TormodDynna/Datamaskinprosjekt-gruppe-2-kicad/README.md

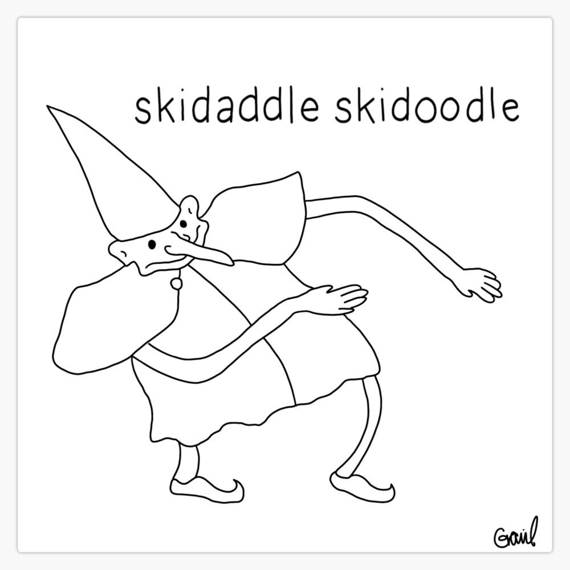
[picture p1: pictures/skidaddle-skidoodle.jpg]
Skidaddle Skidoodle
