TormodDynna/Datamaskinprosjekt-gruppe-2-kicad/pictures/barrel-jack-diagonal.png

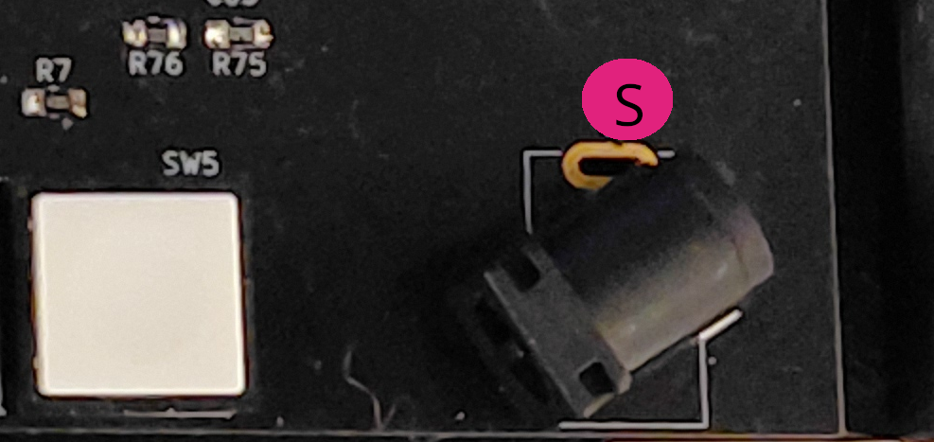
pictures/barrel-jack-diagonal.png
