TormodDynna/Datamaskinprosjekt-gruppe-2-kicad/pictures/PCB-backside.jpg

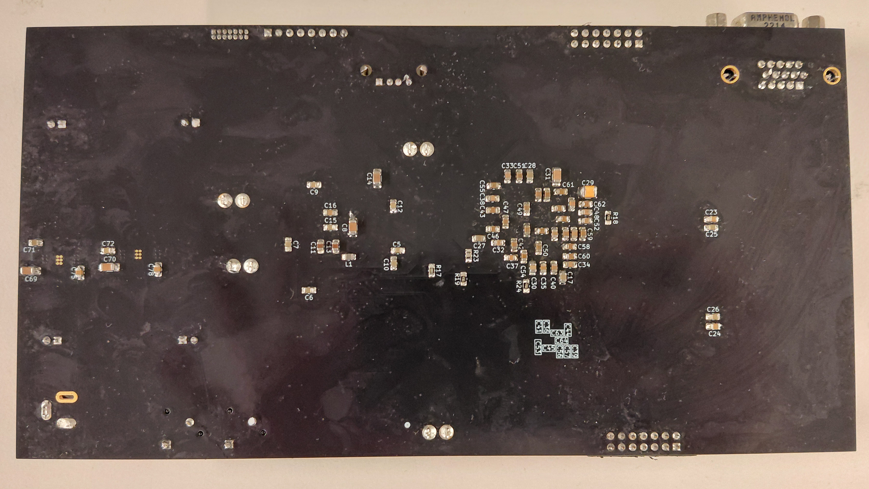
pictures/PCB-backside.jpg
