TormodDynna/Datamaskinprosjekt-gruppe-2-kicad/pictures/PCB-overview/final-PCB-TDT4295.jpg

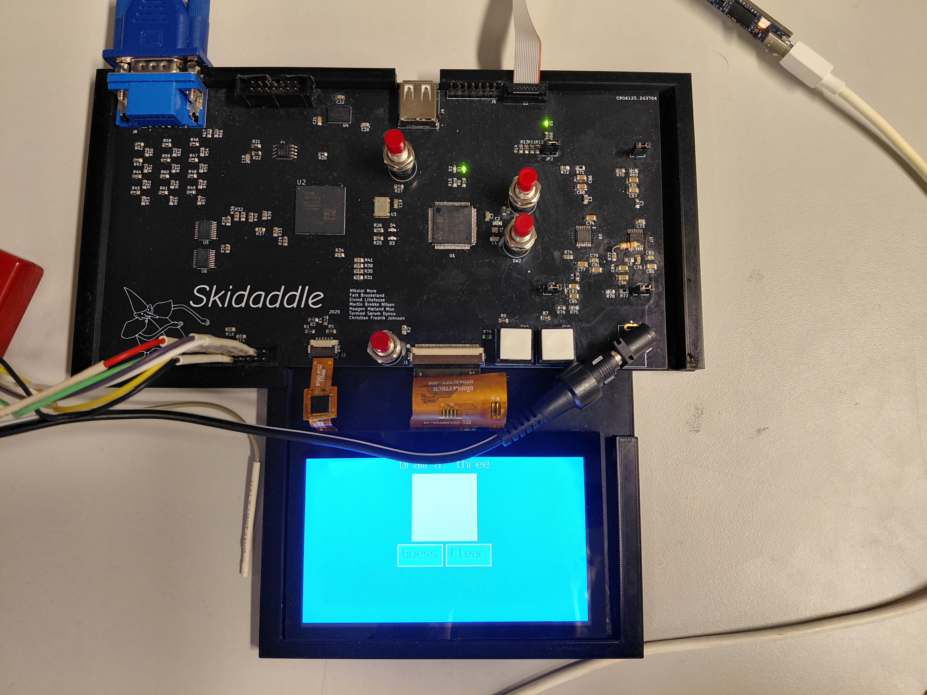
pictures/PCB-overview/final-PCB-TDT4295.jpg
