TormodDynna/Datamaskinprosjekt-gruppe-2-kicad/pictures/system-overview/oversikt-over-system.png

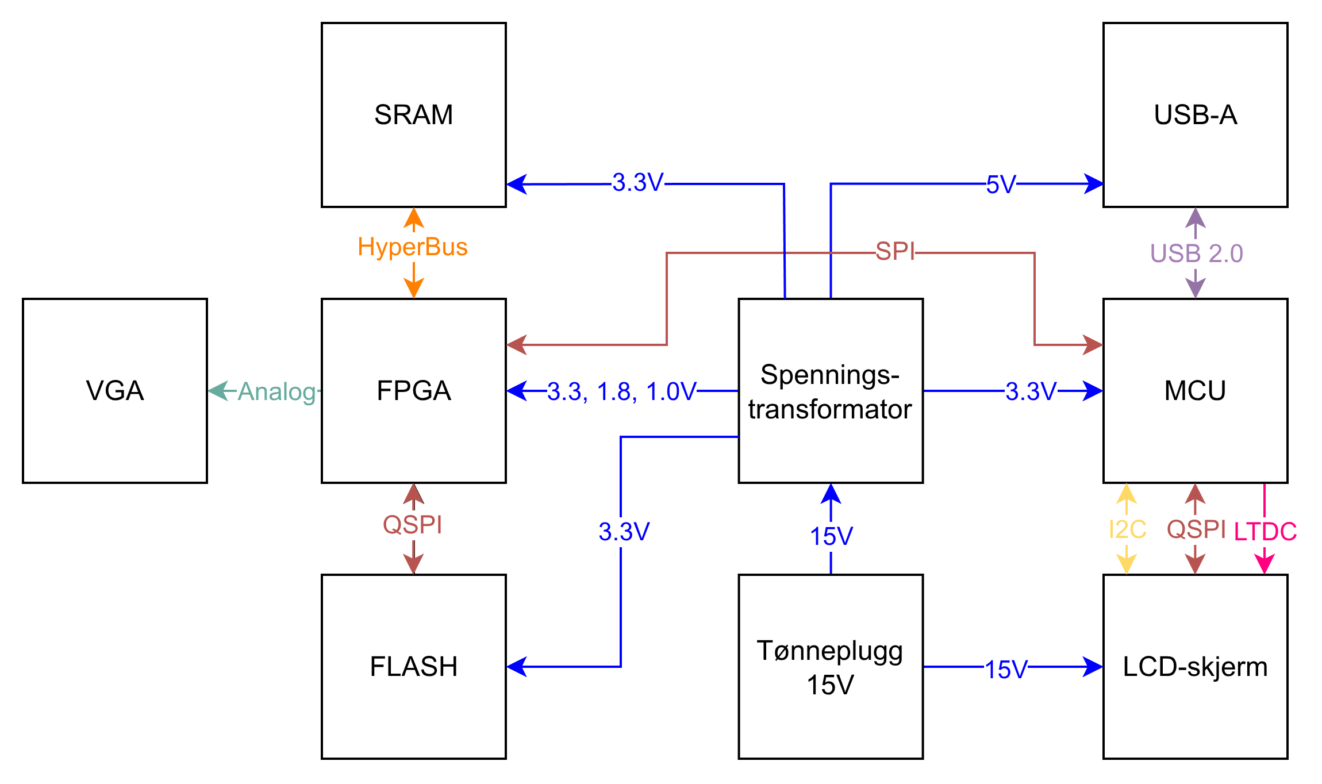
pictures/system-overview/oversikt-over-system.png
