TormodDynna/Datamaskinprosjekt-gruppe-2-kicad/pictures/voltage-transformer-correction/circle-correction-voltage-transformer.png

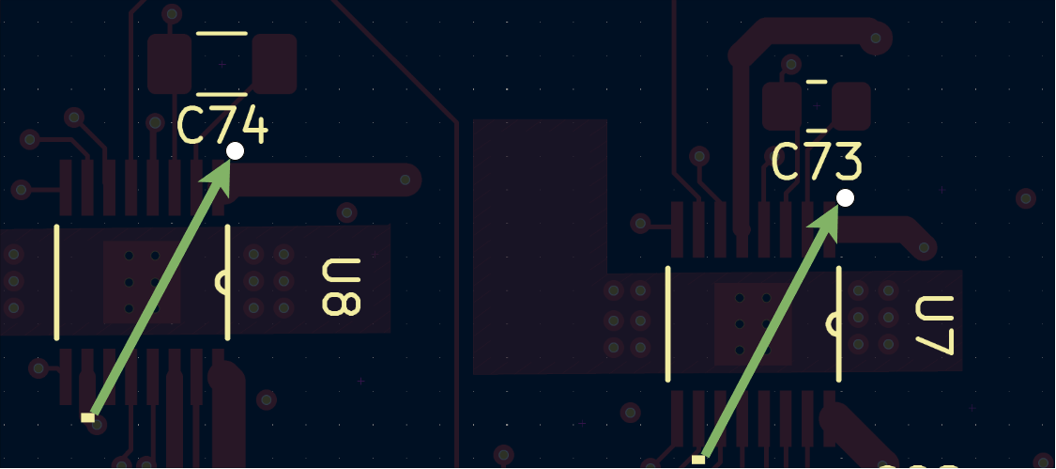
pictures/voltage-transformer-correction/circle-correction-voltage-transformer.png
