TormodDynna/Datamaskinprosjekt-gruppe-2-kicad/pictures/voltage-transformer-correction/transformer-circle.png

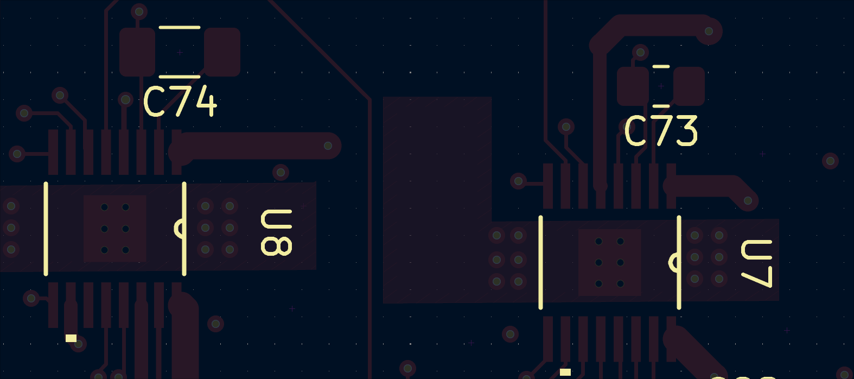
pictures/voltage-transformer-correction/transformer-circle.png
