TormodDynna/Datamaskinprosjekt-gruppe-2-kicad/Handleliste-hardware.xlsx

Komponent | Produsent | Modell | Link | Antall (per PCB) | Antall (x3) | Kjøpe | Pris enkelt | Pris tot | Sendt inn | Faktisk kjøpeantall
MCU | ST Electronics | STM32U5G7VJT6Q | https://www.digikey.no/no/products/detail/stmicroelectronics/STM32U5G7VJT6Q/21700656 | 1 | 3 | 3 | 173.7 | 521.1 | FALSE | 3
MCU/LCD 45-pin connector | Hirose | FH12-45S-0.5SH(55) | https://www.digikey.no/no/products/detail/hirose-electric-co-ltd/FH12-45S-0-5SH-55/1110329 | 1 | 3 | 3 | 29.03 | 87.09 | TRUE
MCU/LCD 6-pin connector | Hirose | FH12-6S-1SH(55) | https://www.digikey.no/no/products/detail/hirose-electric-co-ltd/FH12-6S-1SH-55/1110359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 | 1 | 3 | 3 | 10.09 | 30.27 | TRUE
LCD Breakout 45-pin | Adafruit | 1492 | https://www.digikey.no/no/products/detail/adafruit-industries-llc/1492/5154671 | 1 | 3 | 3 | 30.05 | 90.15 | TRUE
LCD Breakout 6-pin | Chip Quick | FPC100P010 | https://www.digikey.no/no/products/detail/chip-quik-inc/FPC100P010/5014766 | 1 | 3 | 3 | 37.59 | 112.77 | TRUE
LCD Display | Mouser | 758-DT043CTFTIPS-PTS | https://no.mouser.com/ProductDetail/Displaytech/DT043CTFT-IPS-PTS | 1 | 3 | 3 | 542.36 | 1627.08 | TRUE
15V Power Jack | Same Sky | PJ-002A | https://www.digikey.no/no/products/detail/same-sky-formerly-cui-devices/PJ-002A/96962 | 1 | 3 | 3 | 5.3 | 15.9 | FALSE | 3
15V Power Supply | Phihong | PSA15R-150P6-R | https://www.digikey.no/no/products/detail/phihong-usa/PSA15R-150P6-R/5247157 | 1 | 3 | 3 | 93.52 | 280.56 | FALSE | 4
MCU Debug Connector | ST Electronics | STLINK-V3MINIE | https://www.digikey.no/no/products/detail/stmicroelectronics/STLINK-V3MINIE/16284301 | - |  |  |  | 0 | FALSE
USB-A port | On Shore Technology Inc. | USB-A1HSW6 | https://www.digikey.no/no/products/detail/on-shore-technology-inc/USB-A1HSW6/2677750 | 1 | 3 | 4 | 5.09 | 20.36 | FALSE | 4
Undo/Reset Button | C&K | KS11R21CQD | https://www.digikey.no/en/products/detail/c-k/KS11R21CQD/332668 | 2 | 6 | 8 | 28.93 | 231.44 | FALSE | 8
Cheap Button | E-Switch | PS1024ABLK | https://www.digikey.no/en/products/detail/e-switch/PS1024ABLK/81742 | 4 | 12 | 14 | 17.42 | 243.88 | FALSE | 14
VGA Transceiver | Texas Instruments | SN74ALVC245PWR | https://www.digikey.no/en/products/detail/texas-instruments/SN74ALVC245PWR/381176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 | 2 | 6 | 8 | 7.64 | 61.12 | FALSE | 10
LED (Grønn) | Lite-On Inc. | LTST-C193KGKT-5A | https://www.digikey.no/no/products/detail/liteon/LTST-C193KGKT-5A/2356242 | 3 | 9 | 12 | 2.04 | 24.48 | FALSE | 12
LED (Rød) | Lite-On Inc. | LTST-C193KRKT-5A | https://www.digikey.no/no/products/detail/liteon/LTST-C193KRKT-5A/2356244 | 2 | 6 | 8 | 1.73 | 13.84 | FALSE | 8
Krystall (48 MHz, MCU) | Murata Electronics | XRCGB48M000F4M00R0 | https://www.digikey.no/no/products/detail/murata-electronics/XRCGB48M000F4M00R0/2368388 | 1 | 3 | 4 | 3.06 | 12.24 | FALSE | 4
Oscillator (100MHz, FPGA) | Connor Winfield | CWX813-100.0M | https://www.digikey.no/no/products/detail/connor-winfield/CWX813-100-0M/695541 | 1 | 3 | 3 | 51.96 | 155.88 | FALSE | 3
Flash (FPGA) | GigaDevice Semiconductor | GD25F128FS2GR | https://www.digikey.no/no/products/detail/gigadevice-semiconductor-hk-limited/GD25F128FS2GR/20531633 | 1 | 3 | 4 | 38.1 | 152.4 | FALSE | 4
Nedtransformator (Power Supply) | Texas Instruments | TPS54294PWP | https://www.digikey.no/no/products/detail/texas-instruments/TPS54294PWP/2812688 | 2 | 6 | 7 | 33.21 | 232.47 | FALSE | 7
SRAM (FPGA) | Integrated Silicon Solution Inc. | IS66WVH16M8DBLL-100B1LI | https://www.digikey.no/no/products/detail/issi-integrated-silicon-solution-inc/IS66WVH16M8DBLL-100B1LI/6202025 | 1 | 3 | 5 | 48.9 | 244.5 | FALSE | 5
FPGA Debug Header (2x7, 2.54mm) | Sullins Connector Solutions | SBH11-PBPC-D07-ST-BK | https://www.digikey.no/en/products/detail/sullins-connector-solutions/SBH11-PBPC-D07-ST-BK/1990063 | 1 | 3 | 3 | 3.26 | 9.78 | FALSE | 4
FPGA pin header (2x7, 2.54mm) | Sullins Connector Solutions | SBH11-PBPC-D07-ST-BK | https://www.digikey.no/en/products/detail/sullins-connector-solutions/SBH11-PBPC-D07-ST-BK/1990063 | 1 | 3 | 3 | 3.26 | 9.78 | FALSE | 3
MCU Debug Header (2x7, 1.27mm) | CNC Tech | 1175-1630-ND | https://www.digikey.no/en/products/detail/cnc-tech/3220-14-0100-00/3883664 | 1 | 3 | 3 | 7.74 | 23.22 | FALSE | 4
MCU pin header (1x8, 2.54mm) | Würth Elektronik | 61300811121 | https://www.digikey.no/en/products/detail/w%C3%BCrth-elektronik/61300811121/4846839 | 1 | 3 | 3 | 3.67 | 11.01 | FALSE | 4
FPGA | AMD | XC7A100T-2FTG256I | https://www.digikey.no/no/products/detail/amd/XC7A100T-2FTG256I/3925791 | 1 | 3 | 3 | 1774.7 | 5324.1 | FALSE | 3
VGA-port | Amphenol ICC | L77HDE15SD1CH4RHNVGA | https://www.digikey.no/en/products/detail/amphenol-cs-commercial-products/L77HDE15SD1CH4RHNVGA/25816614 | 1 | 3 | 3 | 19.05 | 57.15 | FALSE | 3
PWR Header Pin (2x1, 2.54mm) | Würth Elektronik | 61300211121 | https://www.digikey.no/no/products/detail/w%C3%BCrth-elektronik/61300211121/4846823 | 4 | 12 | 12 | 1.22 | 14.64 | FALSE | 14
Jumper cap | Sullins Connector Solutions | S9337-ND | https://www.digikey.no/en/products/detail/sullins-connector-solutions/QPC02SXGN-RC/2618262 | 4 | 12 | 12 | 1.02 | 12.24 | FALSE | 12
 |  |  |  |  | 0 |  |  | 0
Motstander |  |  |  |  | 0 |  |  | 0
12ohm | 805 |  | https://www.digikey.no/en/products/detail/yageo/RC0805JR-0712RL/728249 | 1 | 3 | 10 | 0.08 | 0.8 | FALSE | 10
47ohm | 805 |  | https://www.digikey.no/no/products/detail/stackpole-electronics-inc/RMCF0805JT47R0/1757848 | 4 | 12 | 16 | 1.02 | 16.32 | FALSE | 16
100ohm | 805 |  | https://www.digikey.no/no/products/detail/panasonic-electronic-components/ERA-6AEB101V/1465724 | 2 | 6 | 8 | 1.02 | 8.16 | FALSE | 10
270ohm | 805 |  | https://www.digikey.no/no/products/detail/vishay-dale/CRCW0805270RFKEAC/7922379 | 14 | 42 | 50 | 1.02 | 51 | FALSE | 50
330ohm | 805 |  | https://www.digikey.no/no/products/detail/stackpole-electronics-inc/RMCF0805FT330R/1760484 | 1 | 3 | 5 | 1.02 | 5.1 | FALSE | 10
536ohm | 805 |  | https://www.digikey.no/no/products/detail/yageo/RC0805FR-07536RL/728026 | 15 | 45 | 55 | 1.02 | 56.1 | FALSE | 55
2.4k | 805 |  | https://www.digikey.no/no/products/detail/yageo/RC0805FR-072K4L/727690 | 1 | 3 | 5 | 1.02 | 5.1 | FALSE | 10
4.7k | 805 |  | https://www.digikey.no/no/products/detail/vishay-dale/CRCW08054K70FKEAC/7928553 | 13 | 39 | 44 | 1.02 | 44.88 | FALSE | 50
6.81k | 805 |  | https://www.digikey.no/no/products/detail/yageo/RC0805FR-076K81L/728068 | 1 | 3 | 5 | 1.02 | 5.1 | FALSE | 10
10k | 805 |  | https://www.digikey.no/no/products/detail/susumu/RR1220P-103-D/432315 | 4 | 12 | 15 | 1.02 | 15.3 | FALSE | 15
22.1k | 805 |  | https://www.digikey.no/no/products/detail/stackpole-electronics-inc/RMCF0805FT22K1/1760211 | 4 | 12 | 15 | 1.02 | 15.3 | FALSE | 15
30.1k | 805 |  | https://www.digikey.no/no/products/detail/vishay-dale/CRCW080530K1FKEA/1175804 | 1 | 3 | 5 | 1.02 | 5.1 | FALSE | 10
73.2k | 805 |  | https://www.digikey.no/no/products/detail/panasonic-electronic-components/ERA-6AEB7322V/2025832 | 1 | 3 | 5 | 1.02 | 5.1 | FALSE | 5
100k | 805 |  | https://www.digikey.no/no/products/detail/susumu/RG2012P-104-B-T5/1240656 | 16 | 48 | 55 | 1.02 | 56.1 | FALSE | 55
124k | 805 |  | https://www.digikey.no/no/products/detail/yageo/RC0805FR-07124KL/727580 | 1 | 3 | 5 | 1.02 | 5.1 | FALSE | 10
Kondensator
6p | 805 |  | https://www.digikey.no/no/products/detail/kyocera-avx/08055A6R0CAT2A/1602729 | 2 | 6 | 8 | 2.04 | 16.32 | FALSE | 10
100n | 805 |  | https://www.digikey.no/no/products/detail/kemet/C0805C104K5RACTU/411169 | 21 | 63 | 70 | 0.82 | 57.4 | FALSE | 70
470n | 805 |  | https://www.digikey.no/no/products/detail/murata-electronics/GCJ21BR71H474KA12L/2783815 | 21 | 63 | 70 | 2.65 | 185.5 | FALSE | 70
1u | 805 |  | https://www.digikey.no/no/products/detail/samsung-electro-mechanics/CL21B105KAFNNNE/3886724 | 6 | 18 | 22 | 0.82 | 18.04 | FALSE | 22
2.2u | 805 |  | https://www.digikey.no/no/products/detail/tdk-corporation/C2012X7R1C225K125AB/569046 | 2 | 6 | 8 | 1.83 | 14.64 | FALSE | 10
4.7u | 805 |  | https://www.digikey.no/no/products/detail/samsung-electro-mechanics/CL21A475KAQNNNE/3886902 | 12 | 36 | 42 | 1.02 | 42.84 | FALSE | 50
47u | 805 |  | https://www.digikey.no/no/products/detail/samsung-electro-mechanics/CL21A476MQYNNNE/3887510 | 4 | 12 | 15 | 1.32 | 19.8 | FALSE | 15
10u | 1206 |  | https://www.digikey.no/no/products/detail/samsung-electro-mechanics/CL31B106KAHNNNE/3887462 | 8 | 24 | 28 | 0.82 | 22.96 | FALSE | 28
22u | 1206 |  | https://www.digikey.no/no/products/detail/samsung-electro-mechanics/CL31A226KAHNNNE/3888705 | 8 | 24 | 28 | 0.92 | 25.76 | FALSE | 28
100u | 1206 |  | https://www.digikey.no/no/products/detail/samsung-electro-mechanics/CL31A107MQHNNWE/10479833 | 1 | 3 | 5 | 4.08 | 20.4 | FALSE | 5
330u | 1210 |  | https://www.digikey.no/no/products/detail/murata-electronics/GRM32ER60G337ME05L/6155746 | 1 | 3 | 4 | 16.61 | 66.44 | FALSE | 4
Spoler
1,5u | 805 |  | https://www.digikey.no/no/products/detail/murata-electronics/LQM21PN1R5MC0D/1788280 | 2 | 6 | 8 | 1.73 | 13.84 | FALSE | 10
2,2u | 805 |  | https://www.digikey.no/no/products/detail/murata-electronics/DFE201210U-2R2M-P2/7595453 | 2 | 6 | 8 | 2.45 | 19.6 | FALSE | 8
3,3u | 805 |  | https://www.digikey.no/no/products/detail/murata-electronics/LQM21PN3R3MGRD/4359175 | 1 | 3 | 5 | 1.73 | 8.65 | FALSE | 5
 |  |  | Antall komponenter per PCB: | 212 |  |  | tot sum | 10446.2 | kr | 802
