TormodDynna/Datamaskinprosjekt-gruppe-2-kicad/tegnebrett/3D_models/PJ-002A.step

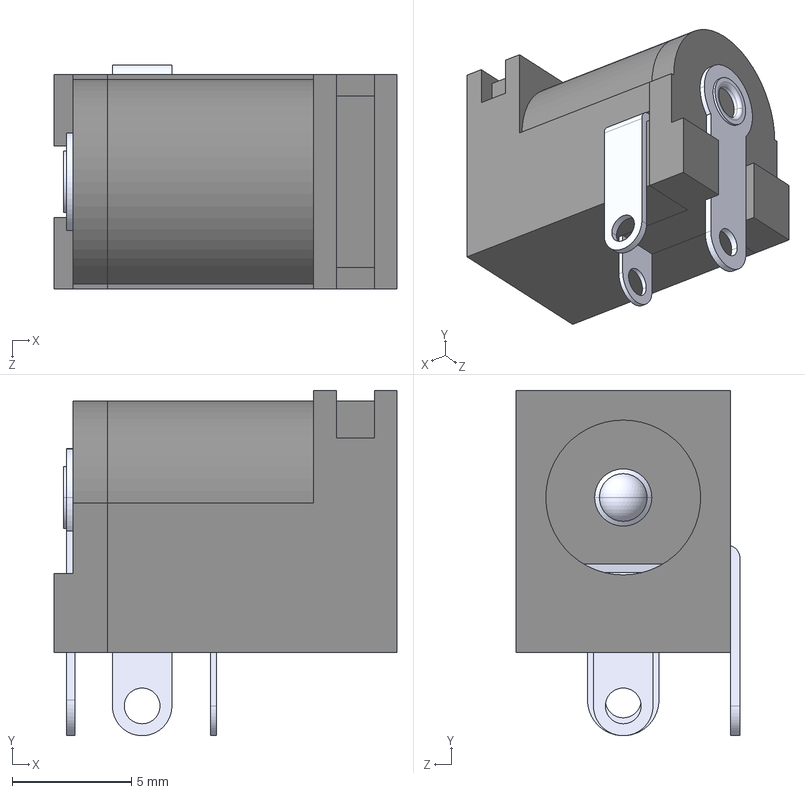
[picture p9: CAD file, 2025-09-28]
tegnebrett/3D_models/PJ-002A.step
14.4 x 14.5 x 9.40 mm
