TormodDynna/Datamaskinprosjekt-gruppe-2-kicad/tegnebrett/3D_models/USB-A1HSW6.step

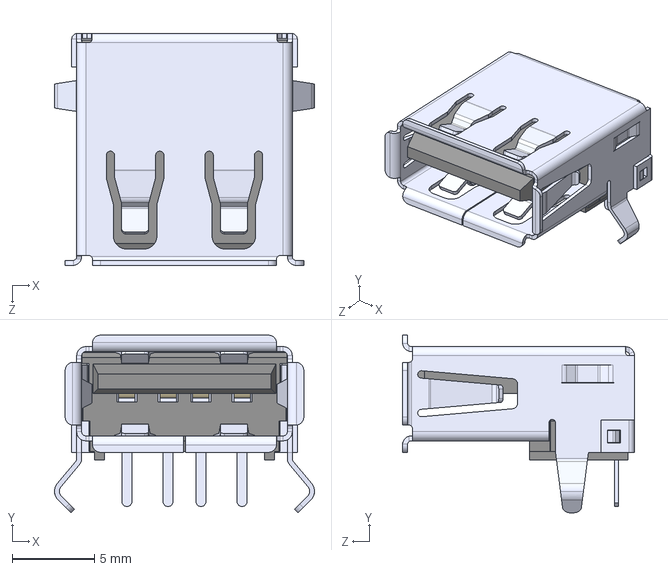
[picture p10: CAD file, 2025-09-25]
tegnebrett/3D_models/USB-A1HSW6.step
15.8 x 10.8 x 14.1 mm
