TormodDynna/Datamaskinprosjekt-gruppe-2-kicad/tegnebrett/3D_models/FH12-6S-1SH.igs

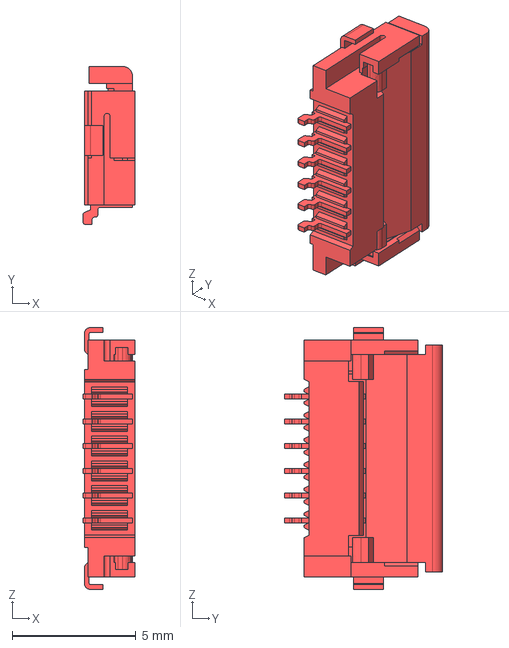
[picture p11: CAD file, 2025-09-25]
tegnebrett/3D_models/FH12-6S-1SH.igs
2.10 x 6.40 x 10.6 mm
