TormodDynna/Datamaskinprosjekt-gruppe-2-kicad/tegnebrett/tegnebrett.kicad_pcb

## KiCad design tegnebrett/tegnebrett.kicad_pcb (2025-10-04)

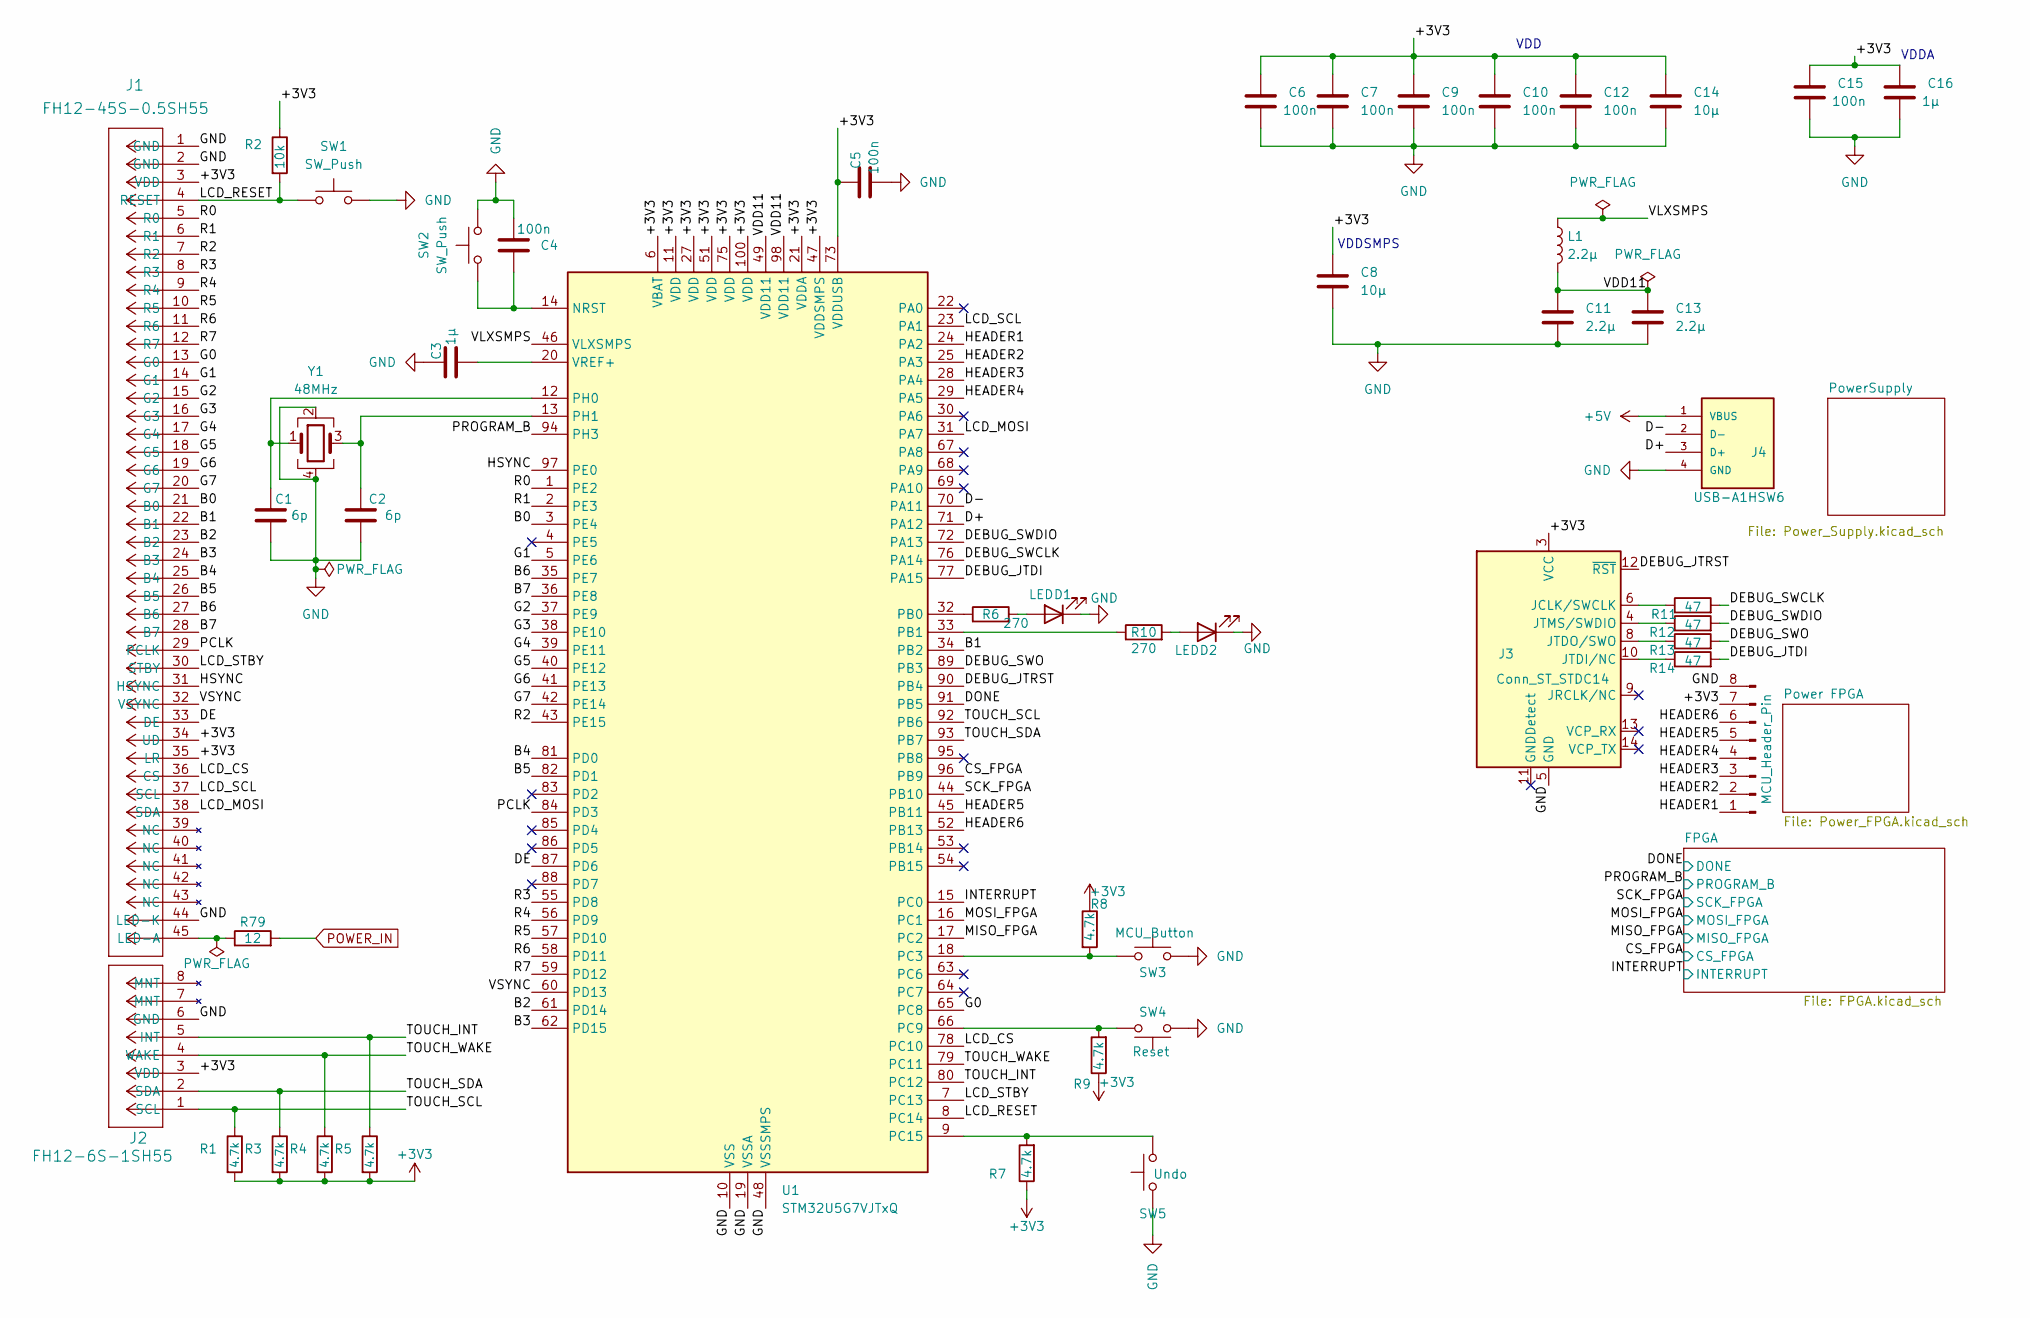
[picture p12: schematic tegnebrett.kicad_sch]

Parts:
C1, C2: 6p; C_0805_2012Metric_Pad1.18x1.45mm_HandSolder
C3, C16: 1µ; C_0805_2012Metric_Pad1.18x1.45mm_HandSolder
C4, C5, C6, C7, C9, C10, C12, C15: 100n; C_0805_2012Metric_Pad1.18x1.45mm_HandSolder
C8, C14: 10µ; C_1206_3216Metric_Pad1.33x1.80mm_HandSolder
C11, C13: 2.2µ; C_0805_2012Metric_Pad1.18x1.45mm_HandSolder
D1, D2: LED; LED_LTST-C193KGKT-5A_LTO-M
J1: FH12-45S-0.5SH55; CONN_45S-0.5SH55
J2: FH12-6S-1SH55; CON6_1X6_DRBF_HST_HIR
J3: Conn_ST_STDC14; PinHeader_2x07_P1.27mm_Vertical
J4: USB-A1HSW6; OST_USB-A1HSW6; PARTREV A
J5: MCU_Header_Pin; PinHeader_1x08_P2.54mm_Vertical
L1: 2.2µ; L_0805_2012Metric_Pad1.15x1.40mm_HandSolder
R1, R3, R4, R5, R7, R8, R9: 4.7k; R_0805_2012Metric_Pad1.20x1.40mm_HandSolder
R2: 10k; R_0805_2012Metric_Pad1.20x1.40mm_HandSolder
R6, R10: 270; R_0805_2012Metric_Pad1.20x1.40mm_HandSolder
R11, R12, R13, R14: 47; R_0805_2012Metric_Pad1.20x1.40mm_HandSolder
R79: 12; R_0805_2012Metric_Pad1.20x1.40mm_HandSolder
SW1, SW2: SW_Push; SW_PS1024ALRED
SW3: MCU_Button; SW_PS1024ALRED
SW4: Reset; SW_KS11R23CQD
SW5: Undo; SW_KS11R23CQD
U1: STM32U5G7VJTxQ; LQFP-100_14x14mm_P0.5mm
Y1: 48MHz; XRCGB48M000F4M00R0_MUR

Connections:
+3V3: C5.1, C6.1, C7.1, C8.1, C9.1, C10.1, C12.1, C14.1, C15.1, C16.1, J1.3 (VDD), J1.34 (UD), J1.35 (LR), J2.3 (VDD), J3.3 (VCC), J5.7, R1.2, R2.1, R3.2, R4.2, R5.2, R7.1, R8.1, R9.1, U1.6 (VBAT), U1.11 (VDD), U1.21 (VDDA), U1.27 (VDD), U1.47 (VDDSMPS), U1.51 (VDD), U1.73 (VDDUSB), U1.75 (VDD), U1.100 (VDD); also elsewhere on the board
+5V: J4.1 (VBUS); also elsewhere on the board
/B0: J1.21 (B0), U1.3 (PE4)
/B1: J1.22 (B1), U1.34 (PB2)
/B2: J1.23 (B2), U1.61 (PD14)
/B3: J1.24 (B3), U1.62 (PD15)
/B4: J1.25 (B4), U1.81 (PD0)
/B5: J1.26 (B5), U1.82 (PD1)
/B6: J1.27 (B6), U1.35 (PE7)
/B7: J1.28 (B7), U1.36 (PE8)
/CS_FPGA: U1.96 (PB9); also elsewhere on the board
/D+: J4.3 (D+), U1.71 (PA12)
/D-: J4.2 (D-), U1.70 (PA11)
/DE: J1.33 (DE), U1.87 (PD6)
/DEBUG_JTDI: R14.2, U1.77 (PA15)
/DEBUG_JTRST: J3.12 (~RST), U1.90 (PB4)
/DEBUG_SWCLK: R11.2, U1.76 (PA14)
/DEBUG_SWDIO: R12.2, U1.72 (PA13)
/DEBUG_SWO: R13.2, U1.89 (PB3)
/DONE: U1.91 (PB5); also elsewhere on the board
/G0: J1.13 (G0), U1.65 (PC8)
/G1: J1.14 (G1), U1.5 (PE6)
/G2: J1.15 (G2), U1.37 (PE9)
/G3: J1.16 (G3), U1.38 (PE10)
/G4: J1.17 (G4), U1.39 (PE11)
/G5: J1.18 (G5), U1.40 (PE12)
/G6: J1.19 (G6), U1.41 (PE13)
/G7: J1.20 (G7), U1.42 (PE14)
/HEADER1: J5.1, U1.24 (PA2)
/HEADER2: J5.2, U1.25 (PA3)
/HEADER3: J5.3, U1.28 (PA4)
/HEADER4: J5.4, U1.29 (PA5)
/HEADER5: J5.5, U1.45 (PB11)
/HEADER6: J5.6, U1.52 (PB13)
/HSYNC: J1.31 (HSYNC), U1.97 (PE0)
/INTERRUPT: U1.15 (PC0); also elsewhere on the board
/LCD_CS: J1.36 (CS), U1.78 (PC10)
/LCD_MOSI: J1.38 (SDA), U1.31 (PA7)
/LCD_RESET: J1.4 (RESET), R2.2, SW1.1, U1.8 (PC14)
/LCD_SCL: J1.37 (SCL), U1.23 (PA1)
/LCD_STBY: J1.30 (STBY), U1.7 (PC13)
/MISO_FPGA: U1.17 (PC2); also elsewhere on the board
/MOSI_FPGA: U1.16 (PC1); also elsewhere on the board
/PCLK: J1.29 (PCLK), U1.84 (PD3)
/PROGRAM_B: U1.94 (PH3); also elsewhere on the board
/R0: J1.5 (R0), U1.1 (PE2)
/R1: J1.6 (R1), U1.2 (PE3)
/R2: J1.7 (R2), U1.43 (PE15)
/R3: J1.8 (R3), U1.55 (PD8)
/R4: J1.9 (R4), U1.56 (PD9)
/R5: J1.10 (R5), U1.57 (PD10)
/R6: J1.11 (R6), U1.58 (PD11)
/R7: J1.12 (R7), U1.59 (PD12)
/SCK_FPGA: U1.44 (PB10); also elsewhere on the board
/TOUCH_INT: J2.5 (INT), R5.1, U1.80 (PC12)
/TOUCH_SCL: J2.1 (SCL), R1.1, U1.92 (PB6)
/TOUCH_SDA: J2.2 (SDA), R3.1, U1.93 (PB7)
/TOUCH_WAKE: J2.4 (WAKE), R4.1, U1.79 (PC11)
/VDD11: C11.1, C13.1, L1.2, U1.49 (VDD11), U1.98 (VDD11)
/VLXSMPS: L1.1, U1.46 (VLXSMPS)
/VSYNC: J1.32 (VSYNC), U1.60 (PD13)
GND: C1.2, C2.2, C3.1, C4.2, C5.2, C6.2, C7.2, C8.2, C9.2, C10.2, C11.2, C12.2, C13.2, C14.2, C15.2, C16.2, D1.1 (K), D2.1 (K), J1.1 (GND), J1.2 (GND), J1.44 (LED-K), J2.6 (GND), J3.5 (GND), J3.7 (GND), J4.4 (GND), J5.8, SW1.2, SW2.2, SW3.2, SW4.1, SW5.1, U1.10 (VSS), U1.19 (VSSA), U1.26 (VSS), U1.48 (VSSSMPS), U1.50 (VSS), U1.74 (VSS), U1.99 (VSS), Y1.2, Y1.4; also elsewhere on the board
unnamed: D1.2 (A), R6.2
unnamed: D2.2 (A), R10.2
unnamed: J1.45 (LED-A), R79.1
unnamed: J3.6 (JCLK/SWCLK), R11.1
unnamed: J3.10 (JTDI/NC), R14.1
unnamed: J3.8 (JTDO/SWO), R13.1
unnamed: J3.4 (JTMS/SWDIO), R12.1
unnamed: C4.1, SW2.1, U1.14 (NRST)
unnamed: R6.1, U1.32 (PB0)
unnamed: R10.1, U1.33 (PB1)
unnamed: R8.2, SW3.1, U1.18 (PC3)
unnamed: R9.2, SW4.3, U1.66 (PC9)
unnamed: R7.2, SW5.3, U1.9 (PC15)
unnamed: C1.1, U1.12 (PH0), Y1.1
unnamed: C2.1, U1.13 (PH1), Y1.3
unnamed: C3.2, U1.20 (VREF+)
POWER_IN: R79.2; also elsewhere on the board

Notes on the sheet:
VDD
VDDSMPS
VDDA

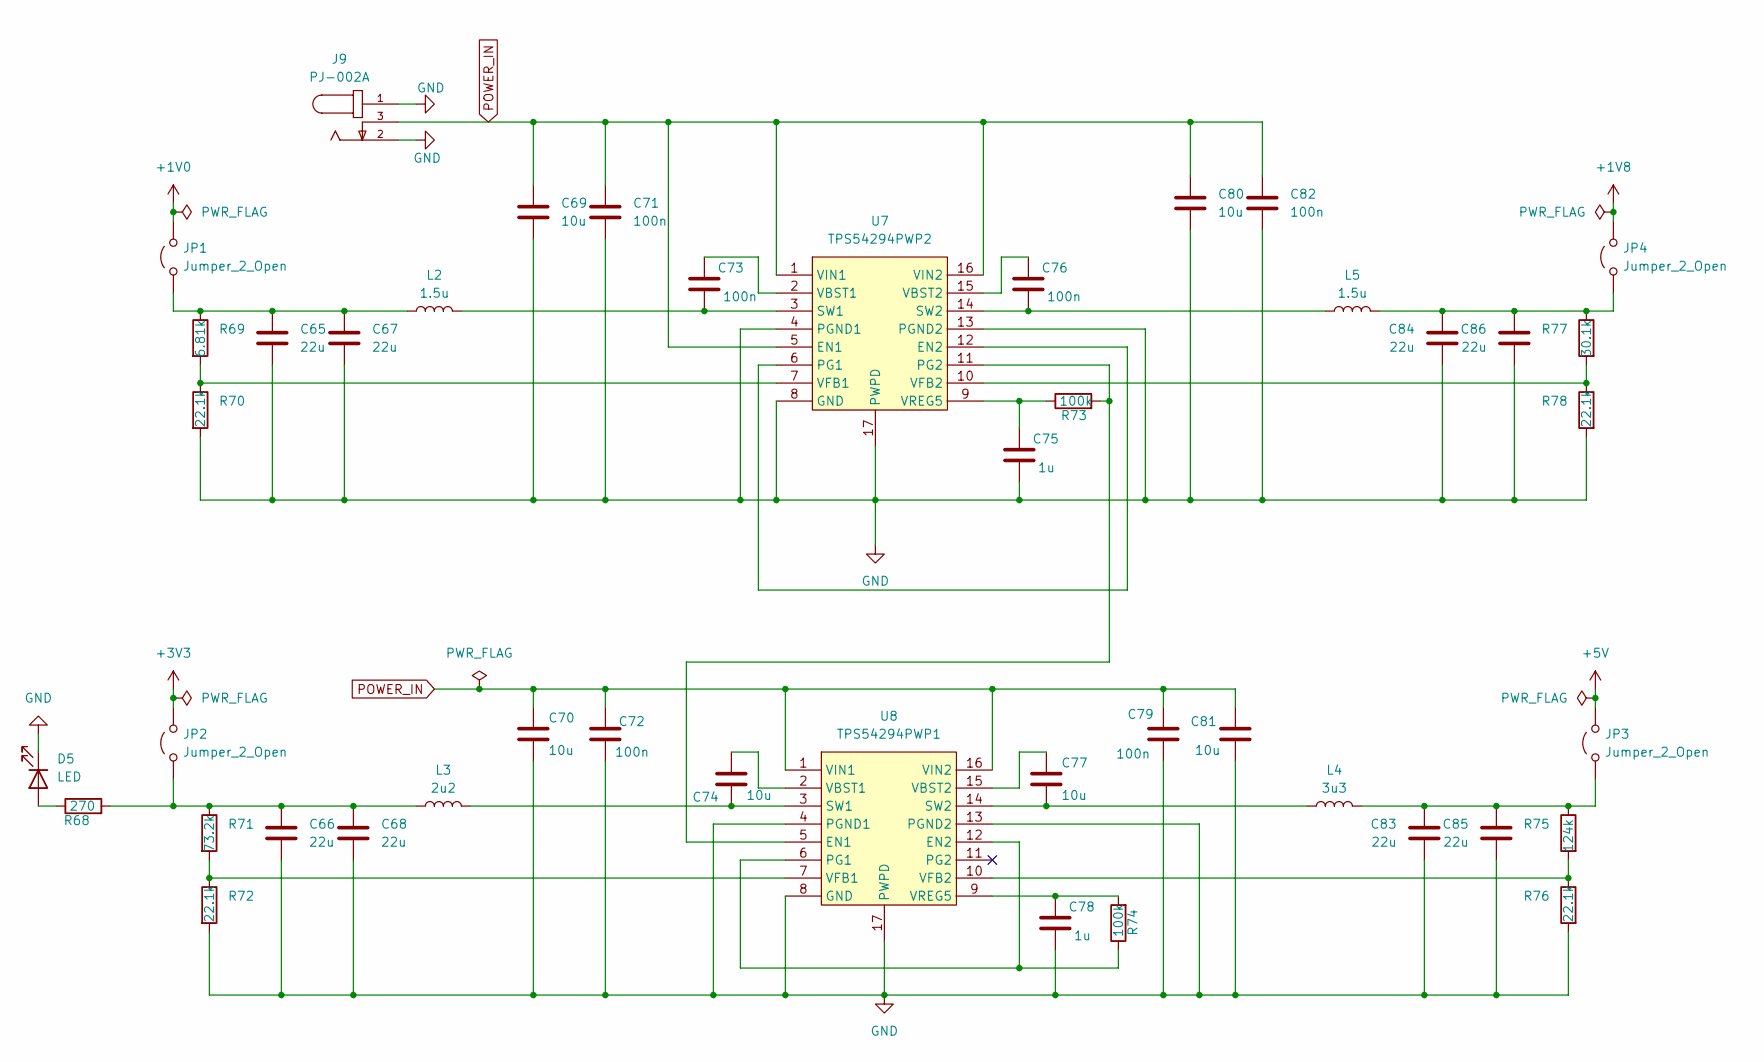
[picture p13: schematic Power_Supply.kicad_sch]

Parts:
C65, C66, C67, C68, C83, C84, C85, C86: 22u; C_1206_3216Metric_Pad1.33x1.80mm_HandSolder
C69, C70, C74, C77, C80, C81: 10u; C_1206_3216Metric_Pad1.33x1.80mm_HandSolder
C71, C72, C73, C76, C79, C82: 100n; C_0805_2012Metric_Pad1.18x1.45mm_HandSolder
C75, C78: 1u; C_0805_2012Metric_Pad1.18x1.45mm_HandSolder
D5: LED; LED_LTST-C193KGKT-5A_LTO-M
J9: PJ-002A; CUI_PJ-002A
JP1, JP2, JP3, JP4: Jumper_2_Open; PinHeader_1x02_P2.54mm_Vertical
L2, L5: 1.5u; L_0805_2012Metric_Pad1.15x1.40mm_HandSolder
L3: 2u2; L_0805_2012Metric_Pad1.15x1.40mm_HandSolder
L4: 3u3; L_0805_2012Metric_Pad1.15x1.40mm_HandSolder
R68: 270; R_0805_2012Metric_Pad1.20x1.40mm_HandSolder
R69: 6.81k; R_0805_2012Metric_Pad1.20x1.40mm_HandSolder
R70, R72, R76, R78: 22.1k; R_0805_2012Metric_Pad1.20x1.40mm_HandSolder
R71: 73.2k; R_0805_2012Metric_Pad1.20x1.40mm_HandSolder
R73, R74: 100k; R_0805_2012Metric_Pad1.20x1.40mm_HandSolder
R75: 124k; R_0805_2012Metric_Pad1.20x1.40mm_HandSolder
R77: 30.1k; R_0805_2012Metric_Pad1.20x1.40mm_HandSolder
U7: TPS54294PWP2; PWP16_2P31X2P46
U8: TPS54294PWP1; PWP16_2P31X2P46

Connections:
+1V0: JP1.2 (B); also elsewhere on the board
+1V8: JP4.2 (B); also elsewhere on the board
+3V3: JP2.2 (B); also elsewhere on the board
+5V: JP3.2 (B); also elsewhere on the board
GND: C65.2, C66.2, C67.2, C68.2, C69.2, C70.2, C71.2, C72.2, C75.2, C78.2, C79.2, C80.2, C81.2, C82.2, C83.2, C84.2, C85.2, C86.2, D5.1 (K), J9.1, J9.2, R70.2, R72.2, R76.2, R78.2, U7.4 (PGND1), U7.8 (GND), U7.13 (PGND2), U7.17 (PWPD), U8.4 (PGND1), U8.8 (GND), U8.13 (PGND2), U8.17 (PWPD); also elsewhere on the board
unnamed: D5.2 (A), R68.1
unnamed: C65.1, C67.1, JP1.1 (A), L2.1, R69.1
unnamed: C66.1, C68.1, JP2.1 (A), L3.1, R68.2, R71.1
unnamed: C83.1, C85.1, JP3.1 (A), L4.1, R75.1
unnamed: C84.1, C86.1, JP4.1 (A), L5.1, R77.1
unnamed: U7.6 (PG1), U7.12 (EN2)
unnamed: R73.2, U7.11 (PG2), U8.5 (EN1)
unnamed: C73.2, L2.2, U7.3 (SW1)
unnamed: C76.2, L5.2, U7.14 (SW2)
unnamed: C73.1, U7.2 (VBST1)
unnamed: C76.1, U7.15 (VBST2)
unnamed: R69.2, R70.1, U7.7 (VFB1)
unnamed: R77.2, R78.1, U7.10 (VFB2)
unnamed: C75.1, R73.1, U7.9 (VREG5)
unnamed: R74.1, U8.6 (PG1), U8.12 (EN2)
unnamed: C74.2, L3.2, U8.3 (SW1)
unnamed: C77.2, L4.2, U8.14 (SW2)
unnamed: C74.1, U8.2 (VBST1)
unnamed: C77.1, U8.15 (VBST2)
unnamed: R71.2, R72.1, U8.7 (VFB1)
unnamed: R75.2, R76.1, U8.10 (VFB2)
unnamed: C78.1, R74.2, U8.9 (VREG5)
POWER_IN: C69.1, C70.1, C71.1, C72.1, C79.1, C80.1, C81.1, C82.1, J9.3, U7.1 (VIN1), U7.5 (EN1), U7.16 (VIN2), U8.1 (VIN1), U8.16 (VIN2); also elsewhere on the board

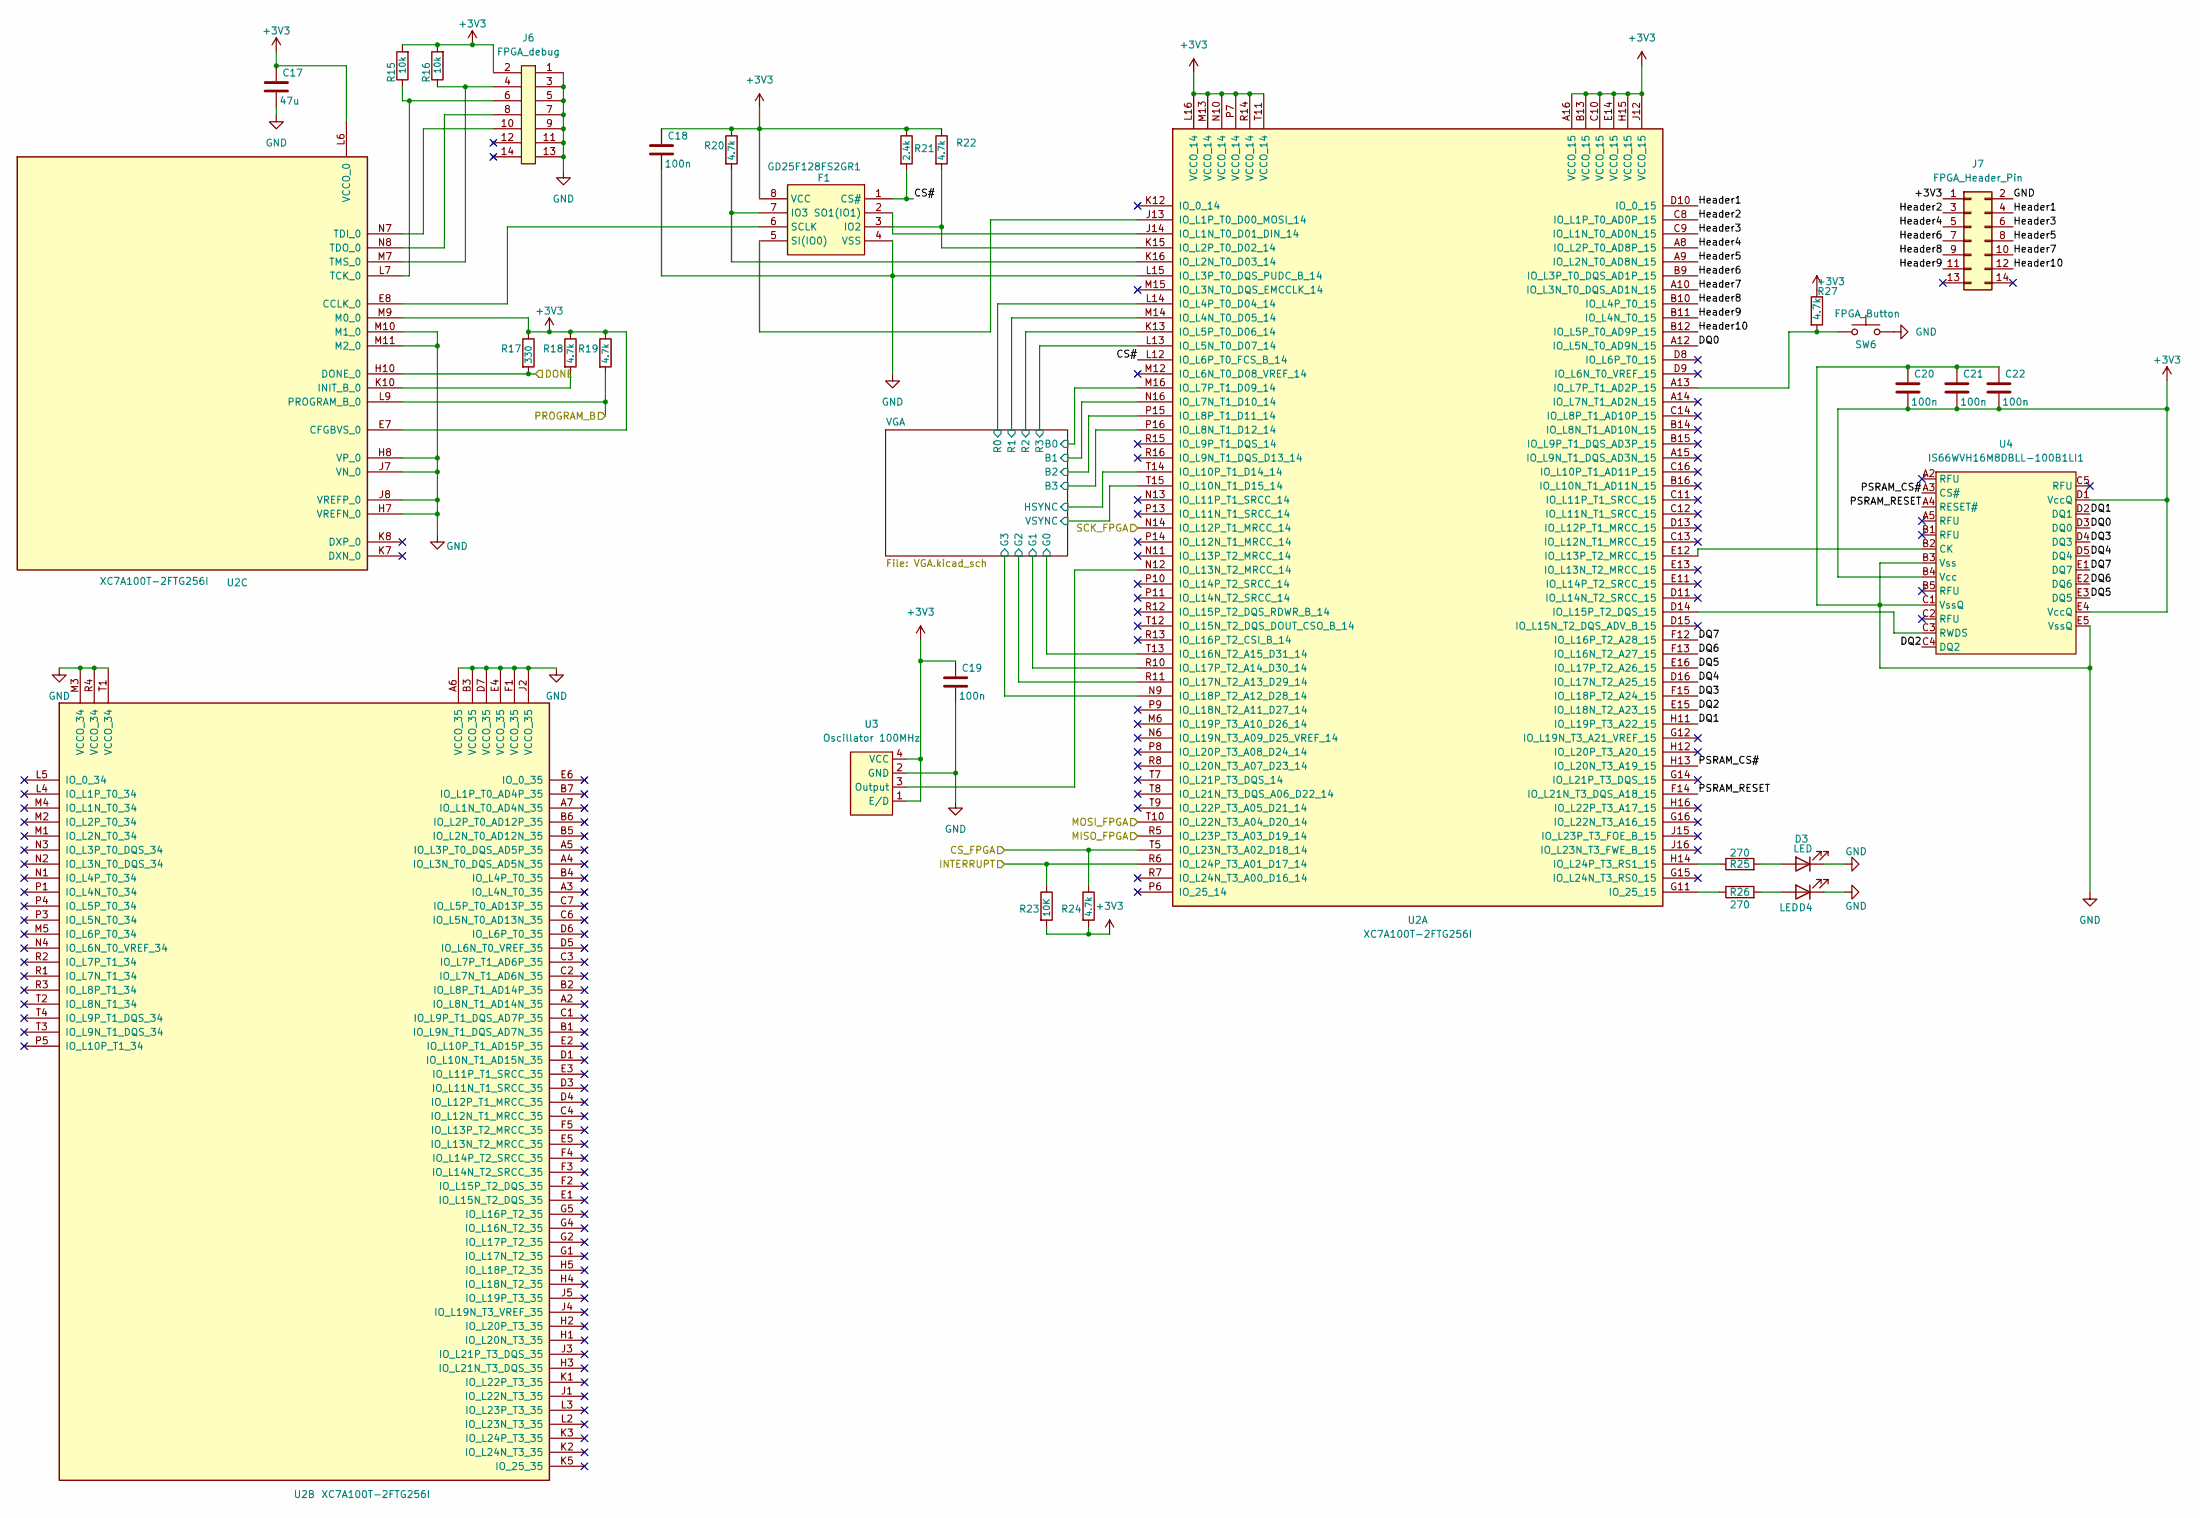
[picture p14: schematic FPGA.kicad_sch]

Parts:
C17: 47u; C_0805_2012Metric_Pad1.18x1.45mm_HandSolder
C18, C19, C20, C21, C22: 100n; C_0805_2012Metric_Pad1.18x1.45mm_HandSolder
D3, D4: LED; LED_LTST-C193KGKT-5A_LTO-M
F1: GD25F128FS2GR1; flash_tegnebrett
J6: FPGA_debug; PinHeader_2x07_P2.54mm_Vertical
J7: FPGA_Header_Pin; PinHeader_2x07_P2.54mm_Vertical
R15, R16: 10k; R_0805_2012Metric_Pad1.20x1.40mm_HandSolder
R17: 330; R_0805_2012Metric_Pad1.20x1.40mm_HandSolder
R18, R19, R20, R22, R24, R27: 4.7k; R_0805_2012Metric_Pad1.20x1.40mm_HandSolder
R21: 2.4k; R_0805_2012Metric_Pad1.20x1.40mm_HandSolder
R23: 10K; R_0805_2012Metric_Pad1.20x1.40mm_HandSolder
R25, R26: 270; R_0805_2012Metric_Pad1.20x1.40mm_HandSolder
SW6: FPGA_Button; SW_PS1024ALRED
U2: XC7A100T-2FTG256I; fpga
U3: Oscillator 100MHz; CWX813-100.0M_CNW
U4: IS66WVH16M8DBLL-100B1LI1; psram

Connections:
+3V3: C17.1, C18.1, C19.1, C20.2, C21.2, C22.2, F1.8 (VCC), J6.2, J7.1, R15.2, R16.2, R17.1, R18.1, R19.1, R20.1, R21.1, R22.1, R23.2, R24.2, R27.1, U2.A16 (VCCO_15), U2.B13 (VCCO_15), U2.C10 (VCCO_15), U2.E7 (CFGBVS_0), U2.E14 (VCCO_15), U2.H15 (VCCO_15), U2.J12 (VCCO_15), U2.L6 (VCCO_0), U2.L16 (VCCO_14), U2.M9 (M0_0), U2.M13 (VCCO_14), U2.N10 (VCCO_14), U2.P7 (VCCO_14), U2.R14 (VCCO_14), U2.T11 (VCCO_14), U3.1 (E/D), U3.4 (VCC), U4.B4 (Vcc), U4.D1 (VccQ), U4.E4 (VccQ); also elsewhere on the board
/CS_FPGA: R24.1, U2.T5 (IO_L23N_T3_A02_D18_14); also elsewhere on the board
/DONE: R17.2, U2.H10 (DONE_0); also elsewhere on the board
/FPGA/CS#: F1.1 (CS#), R21.2, U2.L12 (IO_L6P_T0_FCS_B_14)
/FPGA/DQ0: U2.A12 (IO_L5N_T0_AD9N_15), U4.D3 (DQ0)
/FPGA/DQ1: U2.H11 (IO_L19P_T3_A22_15), U4.D2 (DQ1)
/FPGA/DQ2: U2.E15 (IO_L18N_T2_A23_15), U4.C4 (DQ2)
/FPGA/DQ3: U2.F15 (IO_L18P_T2_A24_15), U4.D4 (DQ3)
/FPGA/DQ4: U2.D16 (IO_L17N_T2_A25_15), U4.D5 (DQ4)
/FPGA/DQ5: U2.E16 (IO_L17P_T2_A26_15), U4.E3 (DQ5)
/FPGA/DQ6: U2.F13 (IO_L16N_T2_A27_15), U4.E2 (DQ6)
/FPGA/DQ7: U2.F12 (IO_L16P_T2_A28_15), U4.E1 (DQ7)
/FPGA/Header1: J7.4, U2.D10 (IO_0_15)
/FPGA/Header2: J7.3, U2.C8 (IO_L1P_T0_AD0P_15)
/FPGA/Header3: J7.6, U2.C9 (IO_L1N_T0_AD0N_15)
/FPGA/Header4: J7.5, U2.A8 (IO_L2P_T0_AD8P_15)
/FPGA/Header5: J7.8, U2.A9 (IO_L2N_T0_AD8N_15)
/FPGA/Header6: J7.7, U2.B9 (IO_L3P_T0_DQS_AD1P_15)
/FPGA/Header7: J7.10, U2.A10 (IO_L3N_T0_DQS_AD1N_15)
/FPGA/Header8: J7.9, U2.B10 (IO_L4P_T0_15)
/FPGA/Header9: J7.11, U2.B11 (IO_L4N_T0_15)
/FPGA/Header10: J7.12, U2.B12 (IO_L5P_T0_AD9P_15)
/FPGA/PSRAM_CS#: U2.H13 (IO_L20N_T3_A19_15), U4.A3 (CS#)
/FPGA/PSRAM_RESET: U2.F14 (IO_L21N_T3_DQS_A18_15), U4.A4 (RESET#)
/FPGA/VGA/B0: U2.M16 (IO_L7P_T1_D09_14); also elsewhere on the board
/FPGA/VGA/B1: U2.N16 (IO_L7N_T1_D10_14); also elsewhere on the board
/FPGA/VGA/B2: U2.P15 (IO_L8P_T1_D11_14); also elsewhere on the board
/FPGA/VGA/B3: U2.P16 (IO_L8N_T1_D12_14); also elsewhere on the board
/FPGA/VGA/G0: U2.T13 (IO_L16N_T2_A15_D31_14); also elsewhere on the board
/FPGA/VGA/G1: U2.R10 (IO_L17P_T2_A14_D30_14); also elsewhere on the board
/FPGA/VGA/G2: U2.R11 (IO_L17N_T2_A13_D29_14); also elsewhere on the board
/FPGA/VGA/G3: U2.N9 (IO_L18P_T2_A12_D28_14); also elsewhere on the board
/FPGA/VGA/HSYNC: U2.T14 (IO_L10P_T1_D14_14); also elsewhere on the board
/FPGA/VGA/R0: U2.L14 (IO_L4P_T0_D04_14); also elsewhere on the board
/FPGA/VGA/R1: U2.M14 (IO_L4N_T0_D05_14); also elsewhere on the board
/FPGA/VGA/R2: U2.K13 (IO_L5P_T0_D06_14); also elsewhere on the board
/FPGA/VGA/R3: U2.L13 (IO_L5N_T0_D07_14); also elsewhere on the board
/FPGA/VGA/VSYNC: U2.T15 (IO_L10N_T1_D15_14); also elsewhere on the board
/INTERRUPT: R23.1, U2.R6 (IO_L24P_T3_A01_D17_14); also elsewhere on the board
/MISO_FPGA: U2.R5 (IO_L23P_T3_A03_D19_14); also elsewhere on the board
/MOSI_FPGA: U2.T10 (IO_L22N_T3_A04_D20_14); also elsewhere on the board
/PROGRAM_B: R19.2, U2.L9 (PROGRAM_B_0); also elsewhere on the board
/SCK_FPGA: U2.N14 (IO_L12P_T1_MRCC_14); also elsewhere on the board
GND: C17.2, C18.2, C19.2, C20.1, C21.1, C22.1, D3.1 (K), D4.1 (K), F1.4 (VSS), J6.1, J6.3, J6.5, J6.7, J6.9, J6.11, J6.13, J7.2, SW6.2, U2.A6 (VCCO_35), U2.B3 (VCCO_35), U2.D7 (VCCO_35), U2.E4 (VCCO_35), U2.F1 (VCCO_35), U2.H7 (VREFN_0), U2.H8 (VP_0), U2.J2 (VCCO_35), U2.J7 (VN_0), U2.J8 (VREFP_0), U2.L15 (IO_L3P_T0_DQS_PUDC_B_14), U2.M3 (VCCO_34), U2.M10 (M1_0), U2.M11 (M2_0), U2.R4 (VCCO_34), U2.T1 (VCCO_34), U3.2 (GND), U4.B3 (Vss), U4.C1 (VssQ), U4.E5 (VssQ); also elsewhere on the board
unnamed: D3.2 (A), R25.2
unnamed: D4.2 (A), R26.2
unnamed: F1.3 (IO2), R22.2, U2.K15 (IO_L2P_T0_D02_14)
unnamed: F1.7 (IO3), R20.2, U2.K16 (IO_L2N_T0_D03_14)
unnamed: F1.6 (SCLK), U2.E8 (CCLK_0)
unnamed: F1.5 (SI(IO0)), U2.J13 (IO_L1P_T0_D00_MOSI_14)
unnamed: F1.2 (SO1(IO1)), U2.J14 (IO_L1N_T0_D01_DIN_14)
unnamed: R26.1, U2.G11 (IO_25_15)
unnamed: R27.2, SW6.1, U2.A13 (IO_L7P_T1_AD2P_15)
unnamed: U2.N12 (IO_L13N_T2_MRCC_14), U3.3 (Output)
unnamed: U2.E12 (IO_L13P_T2_MRCC_15), U4.B2 (CK)
unnamed: U2.D14 (IO_L15P_T2_DQS_15), U4.C3 (RWDS)
unnamed: R25.1, U2.H14 (IO_L24P_T3_RS1_15)
unnamed: R18.2, U2.K10 (INIT_B_0)
unnamed: J6.6, R15.1, U2.L7 (TCK_0)
unnamed: J6.10, U2.N7 (TDI_0)
unnamed: J6.8, U2.N8 (TDO_0)
unnamed: J6.4, R16.1, U2.M7 (TMS_0)

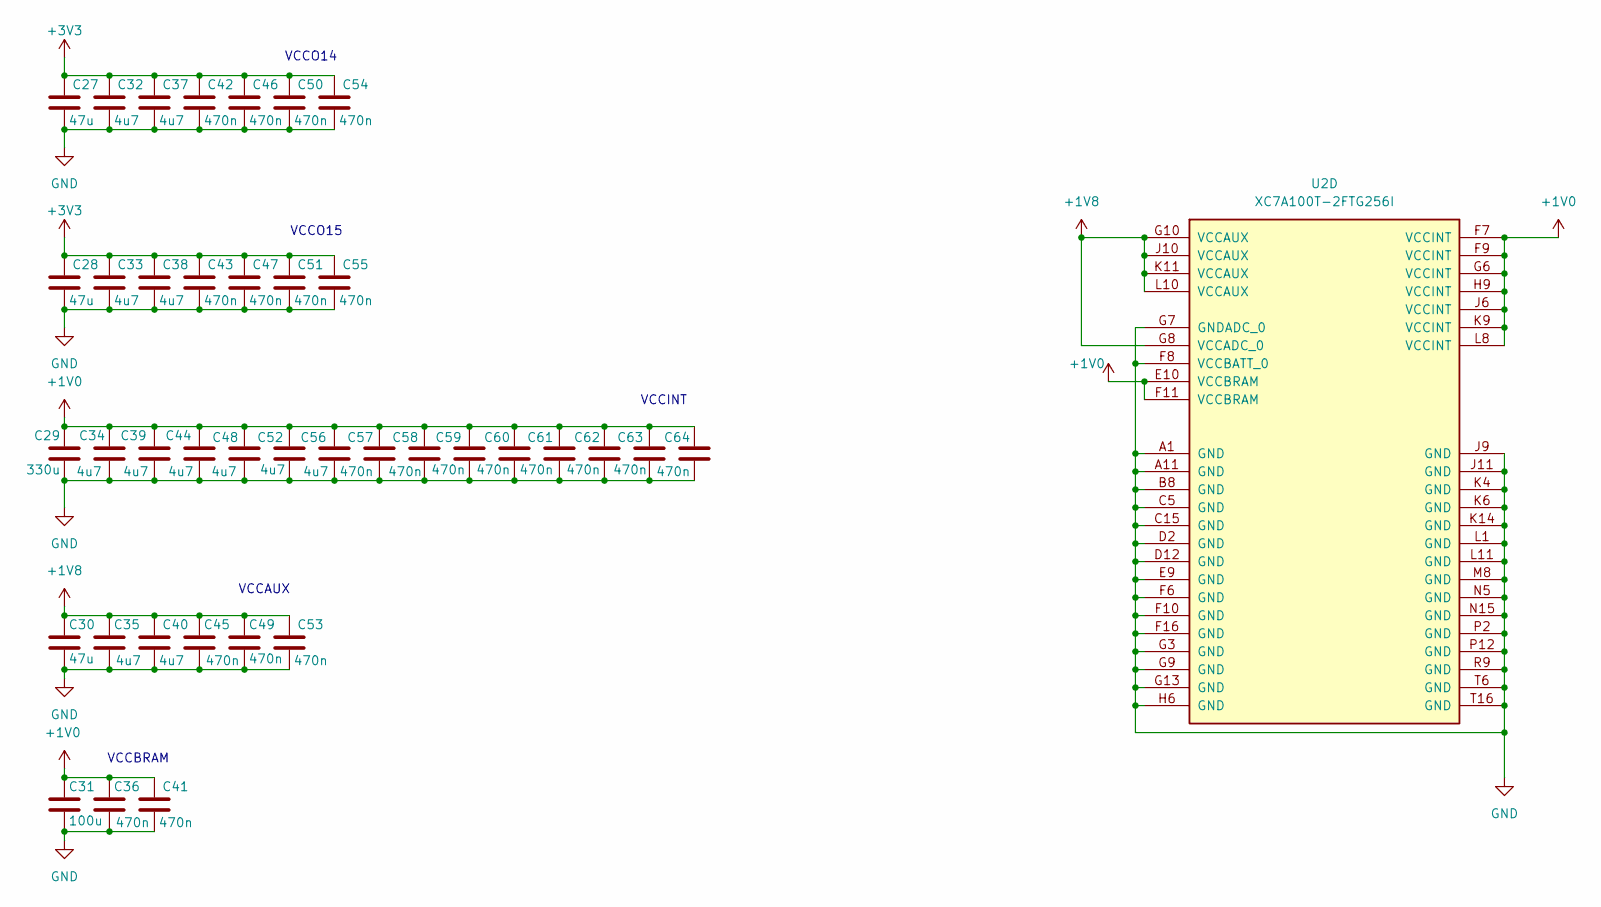
[picture p15: schematic Power_FPGA.kicad_sch]

Parts:
C27, C28, C30: 47u; C_0805_2012Metric_Pad1.18x1.45mm_HandSolder
C29: 330u; C_1210_3225Metric_Pad1.33x2.70mm_HandSolder
C31: 100u; C_1206_3216Metric_Pad1.33x1.80mm_HandSolder
C32, C33, C34, C35, C37, C38, C39, C40, C44, C48, C52, C56: 4u7; C_0805_2012Metric_Pad1.18x1.45mm_HandSolder
C36, C41, C42, C43, C45, C46, C47, C49, C50, C51, C53, C54, C55, C57, C58, C59, C60, C61, C62, C63, C64: 470n; C_0805_2012Metric_Pad1.18x1.45mm_HandSolder
U2: XC7A100T-2FTG256I; fpga

Connections:
+1V0: C29.1, C31.1, C34.1, C36.1, C39.1, C41.1, C44.1, C48.1, C52.1, C56.1, C57.1, C58.1, C59.1, C60.1, C61.1, C62.1, C63.1, C64.1, U2.E10 (VCCBRAM), U2.F7 (VCCINT), U2.F9 (VCCINT), U2.F11 (VCCBRAM), U2.G6 (VCCINT), U2.H9 (VCCINT), U2.J6 (VCCINT), U2.K9 (VCCINT), U2.L8 (VCCINT); also elsewhere on the board
+1V8: C30.1, C35.1, C40.1, C45.1, C49.1, C53.1, U2.G8 (VCCADC_0), U2.G10 (VCCAUX), U2.J10 (VCCAUX), U2.K11 (VCCAUX), U2.L10 (VCCAUX); also elsewhere on the board
+3V3: C27.1, C28.1, C32.1, C33.1, C37.1, C38.1, C42.1, C43.1, C46.1, C47.1, C50.1, C51.1, C54.1, C55.1; also elsewhere on the board
GND: C27.2, C28.2, C29.2, C30.2, C31.2, C32.2, C33.2, C34.2, C35.2, C36.2, C37.2, C38.2, C39.2, C40.2, C41.2, C42.2, C43.2, C44.2, C45.2, C46.2, C47.2, C48.2, C49.2, C50.2, C51.2, C52.2, C53.2, C54.2, C55.2, C56.2, C57.2, C58.2, C59.2, C60.2, C61.2, C62.2, C63.2, C64.2, U2.A1 (GND), U2.A11 (GND), U2.B8 (GND), U2.C5 (GND), U2.C15 (GND), U2.D2 (GND), U2.D12 (GND), U2.E9 (GND), U2.F6 (GND), U2.F8 (VCCBATT_0), U2.F10 (GND), U2.F16 (GND), U2.G3 (GND), U2.G7 (GNDADC_0), U2.G9 (GND), U2.G13 (GND), U2.H6 (GND), U2.J9 (GND), U2.J11 (GND), U2.K4 (GND), U2.K6 (GND), U2.K14 (GND), U2.L1 (GND), U2.L11 (GND), U2.M8 (GND), U2.N5 (GND), U2.N15 (GND), U2.P2 (GND), U2.P12 (GND), U2.R9 (GND), U2.T6 (GND), U2.T16 (GND); also elsewhere on the board

Notes on the sheet:
VCCBRAM
VCCO15
VCCINT
VCCO14
VCCAUX

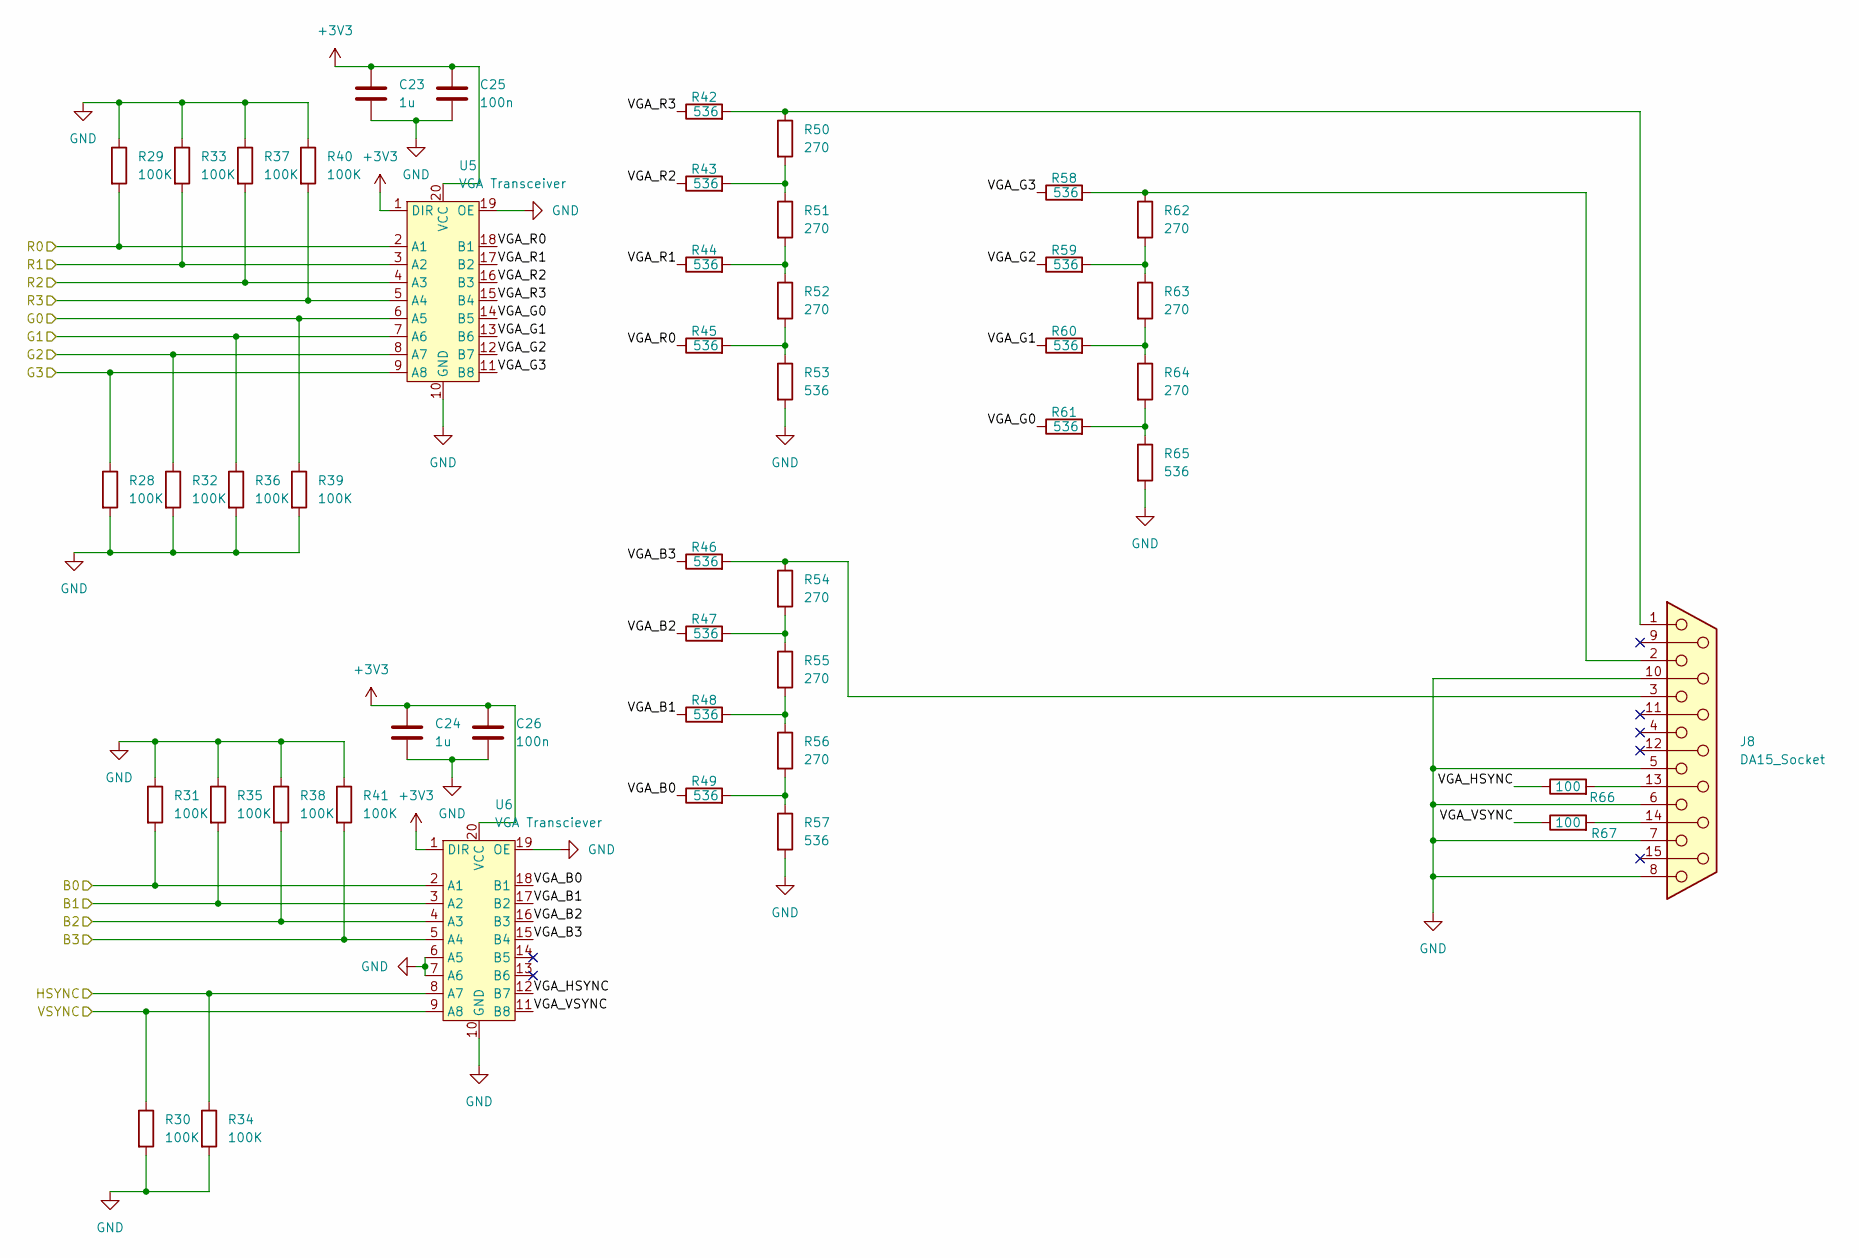
[picture p16: schematic VGA.kicad_sch]

Parts:
C23, C24: 1u; C_0805_2012Metric_Pad1.18x1.45mm_HandSolder
C25, C26: 100n; C_0805_2012Metric_Pad1.18x1.45mm_HandSolder
J8: DA15_Socket; AMPHENOL_L77HDE15SD1CH4RHNVGA
R28, R29, R30, R31, R32, R33, R34, R35, R36, R37, R38, R39, R40, R41: 100K; R_0805_2012Metric_Pad1.20x1.40mm_HandSolder
R42, R43, R44, R45, R46, R47, R48, R49, R53, R57, R58, R59, R60, R61, R65: 536; R_0805_2012Metric_Pad1.20x1.40mm_HandSolder
R50, R51, R52, R54, R55, R56, R62, R63, R64: 270; R_0805_2012Metric_Pad1.20x1.40mm_HandSolder
R66, R67: 100; R_0805_2012Metric_Pad1.20x1.40mm_HandSolder
U5: VGA Transceiver; SOP65P640X120-20N
U6: VGA Transciever; SOP65P640X120-20N

Connections:
+3V3: C23.1, C24.1, C25.1, C26.1, U5.1 (DIR), U5.20 (VCC), U6.1 (DIR), U6.20 (VCC); also elsewhere on the board
/FPGA/VGA/B0: R31.2, U6.2 (A1); also elsewhere on the board
/FPGA/VGA/B1: R35.2, U6.3 (A2); also elsewhere on the board
/FPGA/VGA/B2: R38.2, U6.4 (A3); also elsewhere on the board
/FPGA/VGA/B3: R41.2, U6.5 (A4); also elsewhere on the board
/FPGA/VGA/G0: R39.1, U5.6 (A5); also elsewhere on the board
/FPGA/VGA/G1: R36.1, U5.7 (A6); also elsewhere on the board
/FPGA/VGA/G2: R32.1, U5.8 (A7); also elsewhere on the board
/FPGA/VGA/G3: R28.1, U5.9 (A8); also elsewhere on the board
/FPGA/VGA/HSYNC: R34.1, U6.8 (A7); also elsewhere on the board
/FPGA/VGA/R0: R29.2, U5.2 (A1); also elsewhere on the board
/FPGA/VGA/R1: R33.2, U5.3 (A2); also elsewhere on the board
/FPGA/VGA/R2: R37.2, U5.4 (A3); also elsewhere on the board
/FPGA/VGA/R3: R40.2, U5.5 (A4); also elsewhere on the board
/FPGA/VGA/VGA_B0: R49.1, U6.18 (B1)
/FPGA/VGA/VGA_B1: R48.1, U6.17 (B2)
/FPGA/VGA/VGA_B2: R47.1, U6.16 (B3)
/FPGA/VGA/VGA_B3: R46.1, U6.15 (B4)
/FPGA/VGA/VGA_G0: R61.1, U5.14 (B5)
/FPGA/VGA/VGA_G1: R60.1, U5.13 (B6)
/FPGA/VGA/VGA_G2: R59.1, U5.12 (B7)
/FPGA/VGA/VGA_G3: R58.1, U5.11 (B8)
/FPGA/VGA/VGA_HSYNC: R66.1, U6.12 (B7)
/FPGA/VGA/VGA_R0: R45.1, U5.18 (B1)
/FPGA/VGA/VGA_R1: R44.1, U5.17 (B2)
/FPGA/VGA/VGA_R2: R43.1, U5.16 (B3)
/FPGA/VGA/VGA_R3: R42.1, U5.15 (B4)
/FPGA/VGA/VGA_VSYNC: R67.1, U6.11 (B8)
/FPGA/VGA/VSYNC: R30.1, U6.9 (A8); also elsewhere on the board
GND: C23.2, C24.2, C25.2, C26.2, J8.5, J8.6, J8.7, J8.8, J8.10, R28.2, R29.1, R30.2, R31.1, R32.2, R33.1, R34.2, R35.1, R36.2, R37.1, R38.1, R39.2, R40.1, R41.1, R53.2, R57.2, R65.2, U5.10 (GND), U5.19 (OE), U6.6 (A5), U6.7 (A6), U6.10 (GND), U6.19 (OE); also elsewhere on the board
unnamed: J8.13, R66.2
unnamed: J8.14, R67.2
unnamed: J8.1, R42.2, R50.1
unnamed: J8.2, R58.2, R62.1
unnamed: J8.3, R46.2, R54.1
unnamed: R43.2, R50.2, R51.1
unnamed: R44.2, R51.2, R52.1
unnamed: R45.2, R52.2, R53.1
unnamed: R47.2, R54.2, R55.1
unnamed: R48.2, R55.2, R56.1
unnamed: R49.2, R56.2, R57.1
unnamed: R59.2, R62.2, R63.1
unnamed: R60.2, R63.2, R64.1
unnamed: R61.2, R64.2, R65.1
