TormodDynna/Datamaskinprosjekt-gruppe-2-kicad/tegnebrett/tegnebrett.kicad_pcb

## KiCad design tegnebrett/tegnebrett.kicad_pcb (continued)

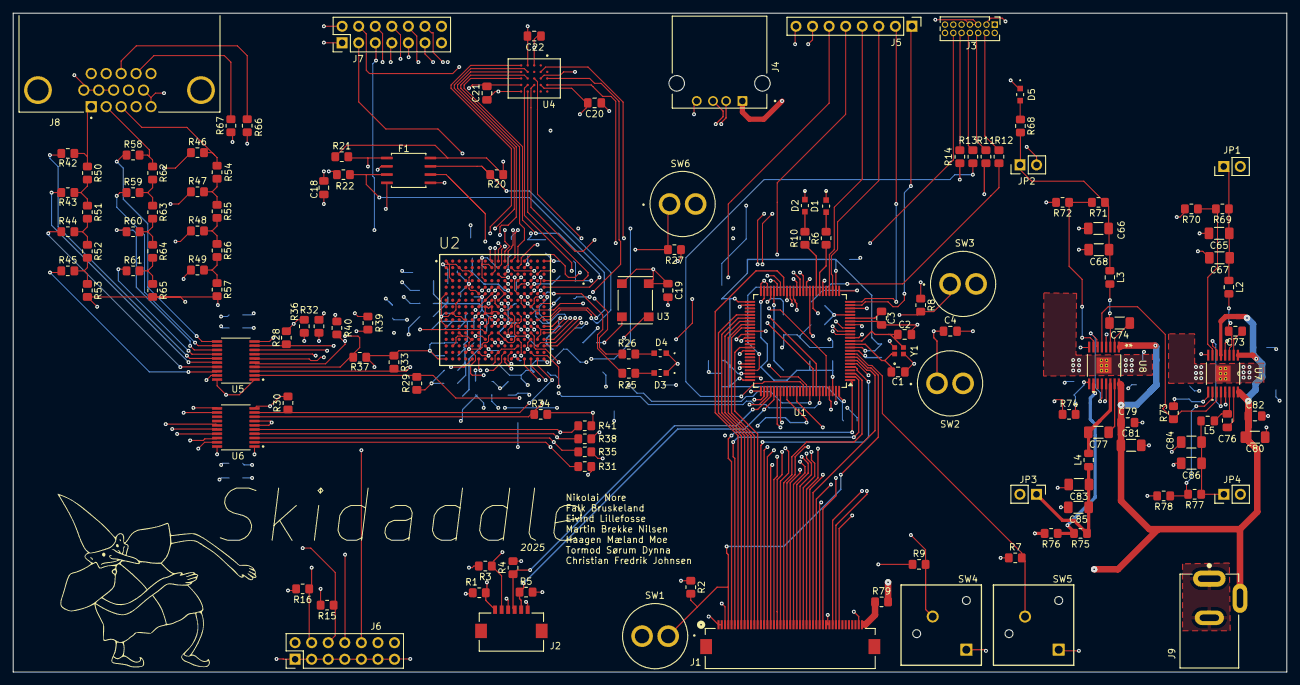
[picture p17: board tegnebrett.kicad_pcb from above]

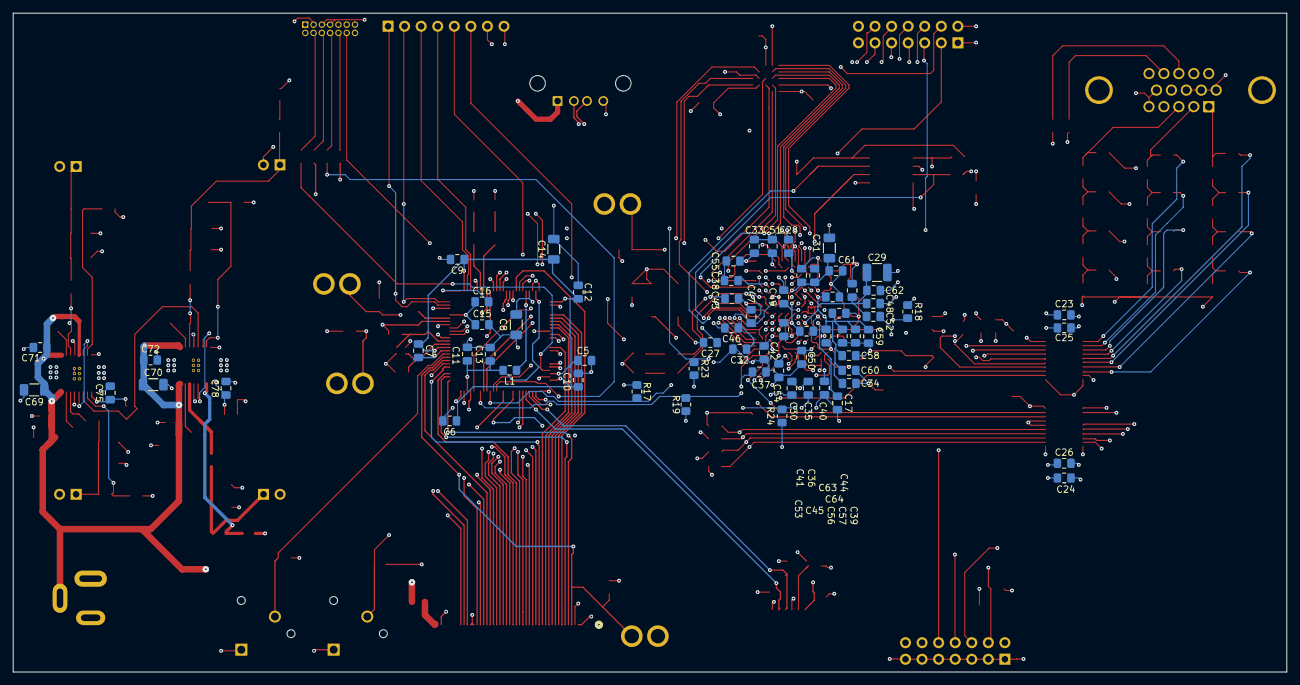
[picture p18: board tegnebrett.kicad_pcb from below]

Board: 6 copper layers, 195.2 x 101.0 mm, 204 parts (67 on the bottom side), 184 nets.
