TormodDynna/Datamaskinprosjekt-gruppe-2-kicad/(commit log)

2025-09-24 feat: PCB update
    Main additions:
    - Added LEDs to Power Supply, MCU and FPGA.
    The resistor values will depend on the specific LEDs we buy.
    Red LEDs need a different resistor value than blue LEDs, etc.
    - Added a bunch of buttons to the MCU
    It doesn't hurt to have some redundancy here.
    - Added header pins
    Allows us to easily reach GPIO pins on the MCU and the FPGA.
    [VGA1.kicad_sch, debug.kicad_sch, getting-started.kicad_pcb, getting-started.kicad_sch, power_supply.kicad_sch, untitled.kicad_sch]
2025-09-24 feat: add Handleliste
    This is a start, where the shopping list has the main components for the
    MCU. We also need to buy a debug pin thing, and probably a connector
    which goes into the debug pin header.
    We also need a USB-A port.
    At a later stage we need to include all the FPGA-related components and
    the power supply.
    I am not looking forward to find all the specific capacitors&resistors we need to
    buy :(((
    [Handleliste-hardware.xlsx]
2025-09-25 shopping list: Add 15V PSU and power jack
    [Handleliste-hardware.xlsx]
2025-09-25 feat(PCB-schematic): add power flags
    This removes a lot of the warnings we're getting from the ERC checker.
    There are still some warnings on the PSU, probably because we've set the
    wrong pin type on some of the pins.
    For example output instead of power output, etc.
    [getting-started.kicad_sch, power_supply.kicad_sch]
2025-09-25 feat: add 3D_models folder for custom modules
    I've currently put the connector 3D models in.
    The 3D model of the MCU is built into KiCAD.
    [FH12-6S-1SH.igs]
2025-09-25 feat: add modules folder
    I've assigned this as a project-specific library in KiCAD, so the models
    which are placed here will be available inside KiCAD.
    Use {KIPRJMOD}/3D_models or {KIPRJMOD}/modules to get into 3d-models and
    modules respecitively. This is portable across computers and operating
    systems.
2025-09-25 feat: added PCB file
    Placed the 45-pin connector and connected the 3D_model for it to the
    footprint.
    [getting-started.kicad_pcb, getting-started.kicad_sch]
2025-09-25 feat: add usb-A symbol, footprint and 3D model
    [USB-A1HSW6.step]
2025-09-25 feat: add USB-A and debug connector to shopping list
    [Handleliste-hardware.xlsx]
2025-09-25 feat: add some footprints
    Added footprints to vertical 8pin connectors and so forth.
    [debug.kicad_sch, getting-started.kicad_sch]
2025-09-26 handleliste: Add USB-A (?)
    Some diff, not sure exactly what it is.
    [Handleliste-hardware.xlsx]
2025-09-26 feat: add USB-A symbol and footprint to schematic
    Also included the 3D model. Now there's some stuff in the PCB.
    [getting-started.kicad_pcb, getting-started.kicad_sch, power_supply.kicad_sch]
2025-09-26 feat: add 3d-models to custom footprints
    6pin and 45pin, USB-A.
    [debug.kicad_sch, getting-started.kicad_pcb, getting-started.kicad_sch]
2025-09-26 feat: add powersupply2
    This version supports 5V output.
    We need 5V to get USB-A working.
    [getting-started.kicad_sch, powersupply2.kicad_sch]
2025-09-26 feat: remove old power supply schmatic
    [getting-started.kicad_sch]
2025-09-26 feat: add resistors between MCU debug and MCU
    These resistors are there in the slides from Asbjørn, so I assume they
    should be there. Couldn't find any information on series resistors to
    the debug pins in the data sheet. So they may or may not be actually
    needed.
    [getting-started.kicad_sch]
2025-09-27 feat: Add footprint to VGA
    Also add VGA to PCB layout.
    [getting-started.kicad_pcb]
2025-09-27 feat: add 100MHz oscillator footprint
    Additionally add the footprint to PCB.
    [VGA1.kicad_sch, debug.kicad_sch, getting-started.kicad_pcb]
2025-09-27 feat: add VGA Transceiver footprint
    Additionally add VGA Transceiver to PCB layout.
    [VGA1.kicad_sch, getting-started.kicad_pcb, powersupply2.kicad_sch]
2025-09-27 feat: add power supply component footprint
    Also add to PCB.
    [getting-started.kicad_pcb, powersupply2.kicad_sch]
2025-09-27 feat: add psram footprint and add to PCB
    [debug.kicad_sch, getting-started.kicad_pcb]
2025-09-27 feat: add FPGA footprint and add footprint to PCB
    [debug.kicad_sch, getting-started.kicad_pcb, untitled.kicad_sch]
2025-09-27 feat: add FPGA flash footprint, import to PCB
    [debug.kicad_sch, getting-started.kicad_pcb]
2025-09-27 feat: Add LED to handleliste
    [Handleliste-hardware.xlsx]
2025-09-27 feat: add LED footprint, and add them to PCB
    [getting-started.kicad_pcb]
2025-09-27 feat: add 48MHz crystal footprint + add to PCB
    [debug.kicad_sch, getting-started.kicad_pcb, getting-started.kicad_sch]
2025-09-27 excel: LED added to Handleliste
    Not sure if this was done properly with the previous related libreOffice
    commit or not.
    [Handleliste-hardware.xlsx]
2025-09-27 docs: Add information on capacitors and their footprints
2025-09-27 feat: add footprint for each capacitor
    It's all 0805, 1206 or 1210 hand soldering variants.
    [VGA1.kicad_sch, debug.kicad_sch, getting-started.kicad_sch, powersupply2.kicad_sch, untitled.kicad_sch]
2025-09-27 feat: add footprints to inductors
    [getting-started.kicad_sch, powersupply2.kicad_sch]
2025-09-27 feat: add inductors and capacitors to PCB
    [getting-started.kicad_pcb]
2025-09-27 docs: Add note on the different resistors and where to buy
2025-09-27 feat: add footprint to resistors
    [VGA1.kicad_sch, debug.kicad_sch, getting-started.kicad_sch, powersupply2.kicad_sch]
2025-09-27 feat: import resistors to PCB
    We're still lacking the resistors to the LEDs, we don't know what values
    those should have.
    [getting-started.kicad_pcb]
2025-09-28 refactor: remove some general bottuns from MCU
    We have gone down from 9 buttons total to 6 buttons total.
    One button is connected to the FPGA.
    [debug.kicad_sch, getting-started.kicad_sch]
2025-09-28 feat: add footprint to FPGA_debug
    [debug.kicad_sch]
2025-09-28 feat: import and add footprints for GamePlay buttons undo and reset
    [getting-started.kicad_sch]
2025-09-28 feat: add and import footprints of trash buttons
    These buttons are cheap and do the job fine.
    [debug.kicad_sch, getting-started.kicad_sch]
2025-09-28 feat: import FPGA_debug header pin and buttons to PCB
    [getting-started.kicad_pcb]
2025-09-28 refactor: remove unused LEDs
    We have too many LEDs.
    We're thinking two LEDs for the MCU and two LEDs for the FPGA.
    Additionally have one Green LED at power supply to indicate that power
    is on.
    [debug.kicad_sch, getting-started.kicad_sch]
2025-09-28 refactor: use new LED variants.
    These have a supply voltage of 2V, and they have a current of 5mA.
    These are nice numbers which gives a required resistance of 260 Ohm,
    assuming a supply voltage of 3.3V
    We're using 270 Ohms though, as 260 is not standard.
    [debug.kicad_sch, getting-started.kicad_sch]
2025-09-28 feat: add new LEDs to handleliste
    [Handleliste-hardware.xlsx]
2025-09-28 feat: add LED to 3.3V from power supply, and set resistors to 270ohm.
    Additionally add footprints to these resistors which *did not* yet have
    a footprint (because their resistor values were not determined yet).
    [debug.kicad_sch, getting-started.kicad_sch, powersupply2.kicad_sch]
2025-09-28 feat: add 15V power jack symbol and import to schematic
    [getting-started.kicad_sch, powersupply2.kicad_sch]
2025-09-28 feat(power-supply): add footprint and 3D model to Power Jack symbol
    [PJ-002A.step, powersupply2.kicad_sch]
2025-09-28 feat: sort components on PCB layout.
    Done by Tormod Sørum Dynna
    [getting-started.kicad_pcb]
2025-09-28 feat: update PCB from schematic.
    Added a few new components, mainly the Power jack connector.
    This update may also have removed some components which are no longer
    used, I don't know for sure.
    [getting-started.kicad_pcb]
2025-09-28 feat: add jumpers to PowerSupply schematic
    [powersupply2.kicad_sch]
2025-09-28 feat: add footprint to jumper and import to PCB
    [getting-started.kicad_pcb, powersupply2.kicad_sch]
2025-09-29 refactor: re-annotate schematic labels
    References for schematic capacitors (for example C74 -> C2), etc.
    [VGA1.kicad_sch, debug.kicad_sch, getting-started.kicad_sch, powersupply2.kicad_sch, untitled.kicad_sch]
2025-09-29 pcb: update from schematic
    reloads the annotations used.
    [getting-started.kicad_pcb]
2025-09-29 refactor: make FPGA_Header_Pin 2x7 instead of 1x8
    We'll get some more GPIO pins exposed.
    [debug.kicad_sch]
2025-09-29 feat: update VGA transceiver symbol
    The bottom ground pin didn't have a number attached to it.
    [VGA1.kicad_sch]
2025-09-29 feat: add power_down_transformator symbol
    I've moved this symbol to the *tegnebrett_symbols* file.
    Apparently it is the case that multiple symbols are stored within one
    .kicad_sym file.
    I **also** moved the PJ (Power Jack) symbol to this file.
    Preparing to remove the PJ symbol file, and also the symbols folder.
    Everything is stored in the (misnamed) USB....kicad_sym file.
2025-09-29 refactor: remove symbols folder
    We have all symbols stored in `tegnebrett/tegnebrett_symbols.kicad_sym`
    Updated the symbol library for the project to use this new file (or
    rather new path).
2025-09-29 refactor: update power-down-transformer symbol
    Update pin functions and so forth.
2025-09-29 schematic: some smaller updates
    I am not entirely sure what was updated, but surely not antyhing huge.
    From the diff we can read that it's perhaps the symbols which got an
    update.
    [VGA1.kicad_sch, getting-started.kicad_sch, powersupply2.kicad_sch]
2025-09-29 feat: update symbol for second power down transformer
    Somehow I had managed to update one symbol, not both (the parts are
    identical).
    [powersupply2.kicad_sch]
2025-09-29 refactor: rename debuc.kicad_sch into FPGA.kicad_sch
    Easier to reason about. Also updated the main sheet such that it refers
    to this new filename.
    [FPGA.kicad_sch, getting-started.kicad_sch]
2025-09-29 refactor: rename untitled to `Power_FPGA`.
    [Power_FPGA.kicad_sch, getting-started.kicad_sch]
2025-09-29 refactor: rename power supply file
    Additionally remove older unused schematics which were present in the
    *tegnebrett* folder.
    [Power_Supply.kicad_sch, getting-started.kicad_sch, power_supply.kicad_sch]
2025-09-29 refactor: rename project from getting-started to tegnebrett
    [tegnebrett.kicad_pcb, tegnebrett.kicad_sch]
2025-09-29 rename: VGA1.kicad_sch got renamed into VGA
    It's confusing to have VGA1 when we only have one VGA schematic sheet.
    [VGA.kicad_sch]
2025-09-29 feat: add custom oscillator symbol
    We're ending up not using it, because *passive* is actually correct pin
    classification, even if the ERC gives errors when we have it on.
2025-09-29 misc: internal updates in schematic files
    project name is being updated from *getting-started* to *tegnebrett*
    [FPGA.kicad_sch, VGA.kicad_sch, tegnebrett.kicad_sch]
2025-09-29 fix: fix footprint paths for symbols
    After moving the footprints around, some symbols were without
    footprints.
    [Power_Supply.kicad_sch, tegnebrett.kicad_sch]
2025-09-29 fix: add PWR_FLAG symbol to Power supply schematic
    This reduces errors, now we only have one error left.
    [Power_Supply.kicad_sch]
2025-09-29 superfeat: PCB updates from Tormod
    [tegnebrett.kicad_pcb]
2025-09-29 refactor(FPGA): move DQ0 pin to reference to different GPIO pin
    As Tormod wrote on Discord:
    H12 (DQ0) -> A12 (IO_L5N_TO_AD9N_15)
    [FPGA.kicad_sch]
2025-09-29 fix: Fix error saying that Ground pin isn't powered by power source.
    Did this by adding a PWR_FLAG to the schematic.
    [tegnebrett.kicad_sch]
2025-09-29 feat: add FH12 symbols
    These were lost somewhere in the process. We're getting KiCAD warnings
    because the former library no longer exists.
    [tegnebrett.kicad_sch]
2025-09-29 fix: remove unused cable
    This removes one warning.
    The cable was connected in one end, unconnected in the other.
    Had no purpose at all.
    [Power_FPGA.kicad_sch]
2025-09-29 fix: add FPGA debug symbol to tegnebrett_symbols library
    This was a symbol added by Tormod which has also been lost to time.
    No problems, we just save the symbol into *tegnebrett_symbols*.
    I believe we will change the pin functions as well.
    [FPGA.kicad_sch]
2025-09-29 refactor: Update label names for hierarchical labels.
    Renamed the hierarchical labels in FPGA.kicad_sch, they now are named
    the say as the local labels in tegnebrett.kicad_sch
    This results in KiCAD no longer throwing any warnings telling us that we
    have labels which only differ in casing (upper case / lower case).
    [FPGA.kicad_sch, tegnebrett.kicad_sch]
2025-09-29 refactor: move SCK_FPGA from N11 to N14
    This allows for easier routing on the PCB.
    [FPGA.kicad_sch]
2025-09-29 fix: add FPGA Oscillator 100MHz to tegnebrett_symbols file
    This is one symbol which Tormod created locally which got lost to time.
    [FPGA.kicad_sch]
2025-09-29 fix: add FPGA Flash to tegnebrett_symbols.kicad_sch
    Once again, a symbol which has got lost to time.
    This removes yet another warning when doing the ERC check.
    [FPGA.kicad_sch]
2025-09-29 fix: remove unused labels in FPGA.kicad_sch
    Two labels which were only defined once (no matching label) were
    removed.
    Result: Two less warnings in the ERC checker. Now only 30 warnings.
    [FPGA.kicad_sch]
2025-09-29 fix: Save FPGA SRAM symbol to tegnebrett_symbols.kicad_sch
    And update symbol in the FPGA.kicad_sch sheet.
    Removes one warning.
    [FPGA.kicad_sch]
2025-09-29 fix: add separate symbols for larger switches.
    They need pin1 and pin3, not pin1 and pin2.
    The PCB editor throws an error when pin3 is not present on the button
    symbol.
    [tegnebrett.kicad_sch]
2025-09-29 refactor: move FPGA button from g12 to a13 pin on FPGA
    g12 -> a13
    This makes the routing easier.
    [FPGA.kicad_sch]
2025-09-29 superfeat: complete PCBv0.1
    Tormod has done a great job!
    Now we're done for the day.
    [tegnebrett.kicad_pcb]
2025-09-30 feat: update Handleliste.xlsx
    Include information on crystal, oscillator, down transformer and FPGA
    flash.
    Additionally included the names of all the parts (except capacitors,
    resistors, buttons, etc.) which I still haven't found the link to.
    [Handleliste-hardware.xlsx]
2025-09-30 docs: add README.md
    Attach *Skidaddle Skidoodle* picture to README.
2025-09-30 chore: move silkprint in PWP16 module
    More changes are coming to this footprint soon, there's some mismatch
    between symbol and footprint.
2025-09-30 docs: add FPGA, VGA-port and SRAM to shopping list
    Oscillator got updated, the initial entry was wrong.
    [Handleliste-hardware.xlsx]
2025-09-30 fix: power down transformer: change pin number from EPAD to 17
    This fixes a warning the PCB editor threw, which said that pin 17 could
    not be found on the footprint.
    [Power_Supply.kicad_sch, tegnebrett.kicad_pcb]
2025-09-30 feat: update PCB
    Pulled the latest changes from Tormod and imported the EPAD -> 17 fix.
    Still, there are some warnings telling us that some footprints have pins
    which are not present on the symbols.
    [tegnebrett.kicad_pcb]
2025-09-30 feat: add skidaddle-logo silkscreen
    Did some image editing in GIMP before getting the size and so forth
    correct.
2025-09-30 fix: refactor Power Supply voltage down transformer
    Edit the pin functions, such that all pins which are going to GND:
    - PGND1
    - PGND2
    - GND
    - PWPD
    Are set to function as *Power Output* instead of *Bi-Directional* or
    *undecided*. This makes the symbol more KiCAD-idiomatic. Removes 8
    warnings.
    [Power_Supply.kicad_sch]
2025-09-30 fix: remove unused circuit label
    Total warning count is now 20.
    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
    [Power_FPGA.kicad_sch]
2025-09-30 fix: edit FPGA_debug symbol
    Set the pins to either Power Input or bi-directional instead of all
    bi-directional (as it was earlier). This yields 8 less warnings.
    [FPGA.kicad_sch]
2025-09-30 fix: Add separate symbol for second VGA-transceiver
    Some pins are bi-directional on the one symbol, but grounded on the
    other. This new symbol and subsequent update to schematic symbol reduces
    the warning count by 2.
    [VGA.kicad_sch]
2025-09-30 fix: add project-local variant of FPGA symbol
    Allows us to set some bi-directional pins to *power input*, as some of
    the bi-directionals are connected to GND and VDD. KiCAD threw warning
    because of that.
    Now the warning count is down to 1.
    [FPGA.kicad_sch, Power_FPGA.kicad_sch]
2025-09-30 feat: PCB good first version
    We've completed something. There are a lot of errors in the PCB related
    to the power transformers which are taking in 15V and converting it
    down.
    [tegnebrett.kicad_pcb]
2025-09-30 fix: remove unused net labels in main MCU sheet
    I had used labels called *VDD_W_DECOUPLING* and so forth, but these were
    identical in nature to +3V3. The chatbot is saying that we ideally
    should have different subnets (whatever that means). Would be necessary
    in larger projects, but it's fine to have just +3V3 in this small
    schematic/PCB layout.
    This removed the last warning in the ERC checker for the schematic.
    We're now at 0 errors and 0 warnings there.
    [Power_FPGA.kicad_sch, tegnebrett.kicad_sch]
2025-09-30 feat: PCB updates
    Latest stuff from Tormod.
    We still have 77 Errors and 2 warnings, but we'll ship this!
    [tegnebrett.kicad_pcb]
2025-09-30 feat: Handleliste almost completed
    We've added most components and their prices.
    We've also got a final sum which seems to be around 10 000 NOK.
    We hadn't checked the prices as we were looking at components, so it's a
    happy coincidence that it landed on 10k very precisely.
    [Handleliste-hardware.xlsx]
2025-09-30 chore: Remove .txt files
    These were used to get a quick overview of our inductors, capacitors and
    resistors. The data has been moved into the excel sheet, so we don't
    need the .txt files anymore.
2025-09-30 feat: add remaining components and prices to Handleliste
    We've now got all (probably) hardware stuff in the shopping list.
    The total price lies at 9909 NOK.
    Should probably check that we've actually included all components, but
    there's a good chance we actually do have them all.
    [Handleliste-hardware.xlsx]
2025-10-01 feat: add buttons and VGA transceiver to shopping list
    We had forgotten to add these elements to the list. Now the list
    consists of 211 components per PCB.
    The Bill of Materials (BoM) is telling us that we have footprints for
    203 components per PCB.
    We get 211 components per PCB, because 8 components do not have a
    footprint on the board. These components are:
    LCD Display (1x)
    LCD Breakout 45pin (1x)
    LCD Breakout 6pin (1x)
    15V Power Supply (1x)
    Jumper Cap (4x)
    [Handleliste-hardware.xlsx]
2025-10-01 fix: Edit footprint such that vias have pin number 17
    This allows KiCAD to understand that the pad and the thermal vias are
    connected to the same layer (GND). It reduces the errors we get from DRC
    in PCB layout from 72 to 10.
2025-10-01 chore: update PCB to include latest footprints
    The footprints which got updated are the two power down transformers.
    [tegnebrett.kicad_pcb]
2025-10-01 fix: change *zone connection style* for thermal vias
    Change from *inherited* to *solid*.
    This means that there are no longer any *copper spokes* going from the
    thermal vias to the rest of the thermal pad (which also has pin number
    17).
    This *increases* thermal conductivity, but makes it somewhat *harder* to
    solder the chip onto the PCB when we're doing hand-soldering.
    Crucially it removes errors in the PCB layout when applied.
    After this footprint update, errors in the PCB layout drop to 0.
2025-10-01 chore: update power transformers in PCB layout
    Completes the transition to *solid* zone connection style for thermal
    vias.
    [tegnebrett.kicad_pcb]
2025-10-02 feat: latest PCB changes
    We have 3 warnings and 3 errors, something like that. But should be
    quick to fix.
    [tegnebrett.kicad_pcb]
2025-10-04 feat: PCB updates
    Latest changes from Tormod. Fixed warnings and errors.
    Additionally moved the LCD screen connector ports to better fit the
    actual LCD screen.
    [tegnebrett.kicad_pcb]
2025-10-04 fix: change layers to get correct impedance
    GND is now on layer2, the USB-A stuff needs correct impedance.
    [tegnebrett.kicad_pcb]
2025-10-04 fix: add resistor to LCD screen
    To ensure that we don't get a situation where the current through the
    LCD blows up.
    [tegnebrett.kicad_sch]
2025-10-04 fix: import LCD resistor to PCB
    Again, this is to limit the current going through the LCD screen.
    [tegnebrett.kicad_pcb]
2025-10-04 fix: add power flag to remove error
    This is for the power going into the LCD backlight.
    [tegnebrett.kicad_sch]
2025-10-04 fix: update FPGA flash footprint
    Now the front silkscreen no longer goes over the holes in the front
    mask.
    [tegnebrett.kicad_pcb]
2025-10-04 fix: move LCD screen 6-pin connector to better position
    1 mm right and 3 mm up into the PCB.
    [tegnebrett.kicad_pcb]
2025-10-04 fix: set Mount pins to have *zone connection style: None*
    I thought this would fix an import warning for the footprints in the PCB
    layout editor, but seems like it doesn't fix the problem.
2025-10-04 docs: latest version of Handleliste-hardware
    [Handleliste-hardware.xlsx]
2025-11-18 docs: add system overview draw.io file
    When opened in draw.io, you'll see a quick overview of the main
    components on the PCB, and the communication interfaces which exist
    between the components.
