TormodDynna/Datamaskinprosjekt-gruppe-2-kicad/pictures/PCB-overview/skidaddle-overview-raw.jpg

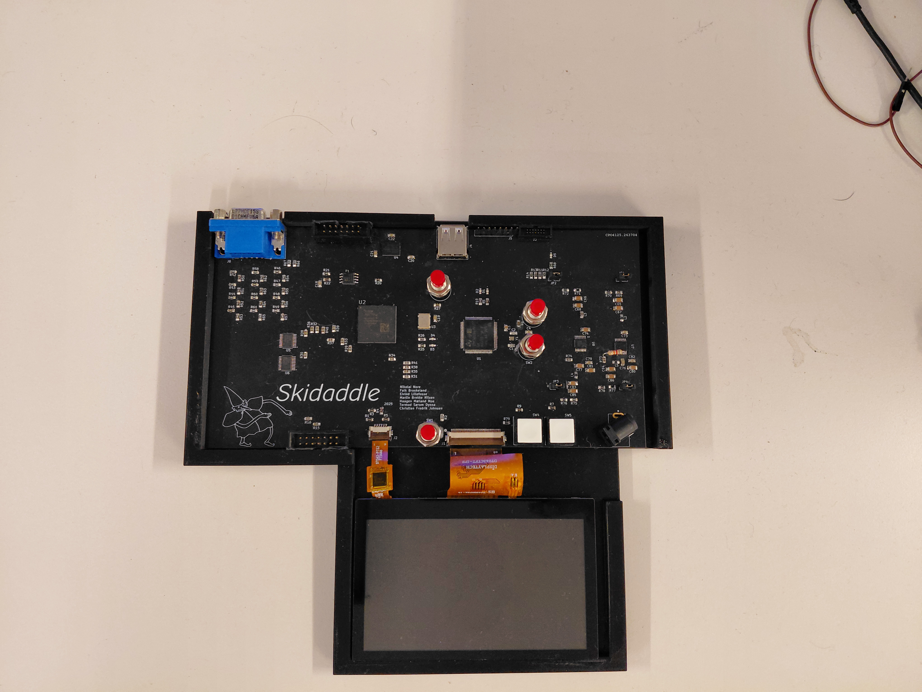
pictures/PCB-overview/skidaddle-overview-raw.jpg
